SebastianHampl18/Bachelorarbeit/Option1/Datenblätter/Links.txt

NPN:
https://www.reichelt.de/de/de/shop/produkt/bipolartransistor_npn_25v_1a_0_25w_sot-23-45228?PROVID=2788

Microcontroller:
Hardware Design Guidelines: 	https://docs.espressif.com/projects/esp-hardware-design-guidelines/en/latest/esp32/index.html
Schematic Checklist: 		https://docs.espressif.com/projects/esp-hardware-design-guidelines/en/latest/esp32/schematic-checklist.html
PCB Layout Design: 		https://docs.espressif.com/projects/esp-hardware-design-guidelines/en/latest/esp32/pcb-layout-design.html

RFID: https://www.berrybase.de/rfid-lesegeraet-mit-spi-schnittstelle-inkl.-karte-dongle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
