SebastianHampl18/Bachelorarbeit/Dokumentation/Arbeit/Deckblatt.docx

Technische Hochschule Nürnberg Georg Simon Ohm
Fakultät Elektro-, Feinwerk-, Informationstechnik

Studiengang Bachelor Elektro- und Informationstechnik
Vertiefungsrichtung Automatisierungstechnik

Bachelorarbeit von
Sebastian Hampl

Entwicklung modularer Steuer- und Kommunikationsschnittstellen für
Elektrokarts auf einem zentralen Steuergerät

Sommersemester 2025
Abgabedatum: 01. Oktober 2025

Betreuer: Firmenbetreuer:
Prof. Dr. Hritam Dutta M. Eng. K. Beckert
leomax engineering GmbH
