SebastianHampl18/Bachelorarbeit/Dokumentation/Arbeit/Prüfungsrechtliche Erklärung unterschrieben.pdf

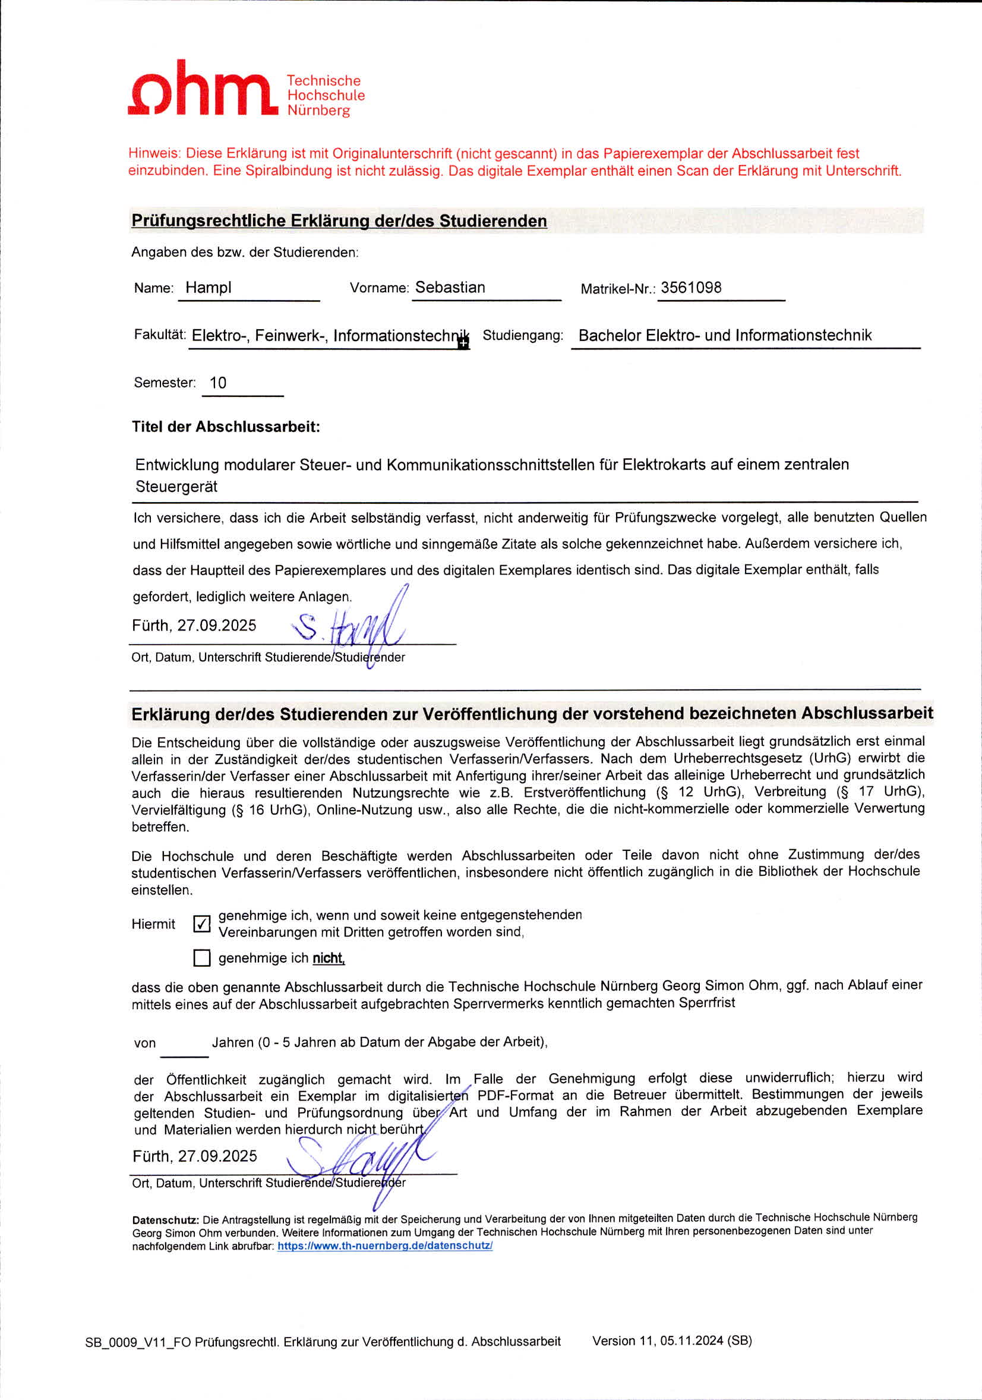
[picture p118: page 1]
