SebastianHampl18/Bachelorarbeit/Option1/Bilder/Strapping Config.png

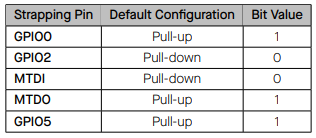
Option1/Bilder/Strapping Config.png
