SebastianHampl18/Bachelorarbeit/Dokumentation/Paarvergleich_Nutzwertanalysen.xlsx

Sheet: Tabelle1
 |  |  | 0 |  |  |  | Nutzwertanalyse
 | Paarvergleich
 |  |  |  |  |  |  | Kriterien | Normiert | Konzept
 | Kriterien | 0 |  | Summe | Normiert | Beschreibung des Kriteriums (Ausprägung, Bewertungsgrenzen, …) |  |  | Bewertung | Gewichtet | Bewertung | Gewichtet | Bewertung | Gewichtet | Bewertung | Gewichtet | Bewertung | Gewichtet
 |  |  |  | 0 | #DIV/0! |  |  | #DIV/0! |  | #DIV/0! |  | #DIV/0! |  | #DIV/0! |  | #DIV/0! |  | #DIV/0!
 |  |  |  | 0 | #DIV/0! |  |  | #DIV/0! |  | #DIV/0! |  | #DIV/0! |  | #DIV/0! |  | #DIV/0! |  | #DIV/0!
2 |  |  |  | 0 | #DIV/0! |  |  | #DIV/0! |  | #DIV/0! |  | #DIV/0! |  | #DIV/0! |  | #DIV/0! |  | #DIV/0!
 |  |  |  | 0 | #DIV/0! |  |  | #DIV/0! |  | #DIV/0! |  | #DIV/0! |  | #DIV/0! |  | #DIV/0! |  | #DIV/0!
 |  |  |  | 0 | #DIV/0! |  |  | #DIV/0! |  | #DIV/0! |  | #DIV/0! |  | #DIV/0! |  | #DIV/0! |  | #DIV/0!
 |  |  |  | 0 | #DIV/0! |  |  | #DIV/0! |  | #DIV/0! |  | #DIV/0! |  | #DIV/0! |  | #DIV/0! |  | #DIV/0!
 |  |  |  | 0 | #DIV/0! |  |  | #DIV/0! |  | #DIV/0! |  | #DIV/0! |  | #DIV/0! |  | #DIV/0! |  | #DIV/0!
 |  |  |  | 0 | #DIV/0! |  |  | #DIV/0! |  | #DIV/0! |  | #DIV/0! |  | #DIV/0! |  | #DIV/0! |  | #DIV/0!
 |  |  |  | 0 | #DIV/0! |  |  | #DIV/0! |  | #DIV/0! |  | #DIV/0! |  | #DIV/0! |  | #DIV/0! |  | #DIV/0!
 |  |  |  | 0 | #DIV/0! |  |  | #DIV/0! |  | #DIV/0! |  | #DIV/0! |  | #DIV/0! |  | #DIV/0! |  | #DIV/0!
 |  |  |  | 0 | #DIV/0! |  |  |  | #DIV/0! |  | #DIV/0! |  | #DIV/0! |  | #DIV/0! |  | #DIV/0!
 |  |  |  |  |  |  |  |  | #DIV/0! |  | #DIV/0! |  | #DIV/0! |  | #DIV/0! |  | #DIV/0!
 | "2" - Zeile wichtiger als Spalte "1" - Beide Kriterien gleich wichtig "0" - Spalte wichtiger als Zeile |  |  |  |  |  | "3" - Sehr gute Erfüllung des Kriteriums "2" - Gute Erfüllung des Kriteriums "1" - Befriedigende Erfüllung des Kriteriums "0" - Mangelhafte Erfüllung des Kriteriums

Sheet: Tabelle2
 | Paarvergleich | 0 |  |  |  | Nutzwertanalyse |  | Konzept 1 |  | Konzept 1 |  | Konzept 1 |  | Konzept 1
 | Kriterien |  | Summe | Normiert | Beschreibung des Kriteriums | Kriterien | Normiert | Bewertung | Gewichtet | Bewertung | Gewichtet | Bewertung | Gewichtet | Bewertung | Gewichtet
2 |  |  | 0 | #DIV/0! |  |  | #DIV/0! |  | #DIV/0! |  | #DIV/0! |  | #DIV/0! |  | #DIV/0!
 |  |  | 0 | #DIV/0! |  |  | #DIV/0! |  | #DIV/0! |  | #DIV/0! |  | #DIV/0! |  | #DIV/0!
 |  |  | 0 | #DIV/0! |  |  | #DIV/0! |  | #DIV/0! |  | #DIV/0! |  | #DIV/0! |  | #DIV/0!
 |  |  | 0 | #DIV/0! |  |  | #DIV/0! |  | #DIV/0! |  | #DIV/0! |  | #DIV/0! |  | #DIV/0!
 |  |  | 0 | #DIV/0! |  |  | #DIV/0! |  | #DIV/0! |  | #DIV/0! |  | #DIV/0! |  | #DIV/0!
 |  |  | 0 | #DIV/0! |  |  | #DIV/0! |  | #DIV/0! |  | #DIV/0! |  | #DIV/0! |  | #DIV/0!
 |  |  | 0 | #DIV/0! |  |  | #DIV/0! |  | #DIV/0! |  | #DIV/0! |  | #DIV/0! |  | #DIV/0!
 |  |  | 0 | #DIV/0! |  |  | #DIV/0! |  | #DIV/0! |  | #DIV/0! |  | #DIV/0! |  | #DIV/0!
 |  |  | 0 | #DIV/0! |  |  | #DIV/0! |  | #DIV/0! |  | #DIV/0! |  | #DIV/0! |  | #DIV/0!
 |  |  | 0 | #DIV/0! |  |  | #DIV/0! |  | #DIV/0! |  | #DIV/0! |  | #DIV/0! |  | #DIV/0!
 |  |  | 0 | #DIV/0! |  |  |  | #DIV/0! |  | #DIV/0! |  | #DIV/0! |  | #DIV/0!
 |  |  |  |  |  |  |  | #DIV/0! |  | #DIV/0! |  | #DIV/0! |  | #DIV/0!

Sheet: Beispiel
 | Paarvergleich | 0 |  |  |  |  |  |  |  | Nutzwertanalyse |  | Konzept 1 |  | Konzept 2 |  | Konzept 3 |  | Konzept 4
 | Kriterien | Kosten | Aufwand | Störungssicherheit | Wartbarkeit | Fehlersuche | Summe | Normiert | Beschreibung des Kriteriums | Kriterien | Normiert | Bewertung | Gewichtet | Bewertung | Gewichtet | Bewertung | Gewichtet | Bewertung | Gewichtet
2 | Kosten |  | 2 | 0 | 0 | 0 | 2 | 0.1 | Möglichst geringe gesamtkosten für Anschaffung und Entwicklung des Systems | Kosten | 0.1 | 3 | 0.3 | 2 | 0.2 | 0 | 0 | 2 | 0.2
 | Aufwand | 0 |  | 0 | 0 | 0 | 0 | 0 | möglichst niedriger zeitlicher Aufwand von der Entwicklung bis zum fertigen Produkt | Aufwand | 0 | 3 | 0 | 1 | 0 | 0 | 0 | 2 | 0
 | Störungssicherheit | 2 | 2 |  | 2 | 2 | 8 | 0.4 | bestmögliche Resistenz gegenüber elektrischen Störungen wie EMV | Störungssicherheit | 0.4 | 0 | 0 | 3 | 1.2 | 3 | 1.2 | 1 | 0.4
 | Wartbarkeit | 2 | 2 | 0 |  | 1 | 5 | 0.25 | beste Möglichkeiten zur Fehlerbehebung und Fehlervermeidung | Wartbarkeit | 0.25 | 0 | 0 | 1 | 0.25 | 2 | 0.5 | 3 | 0.75
 | Fehlersuche | 2 | 2 | 0 | 1 |  | 5 | 0.25 | möglichst geringer Aufwand um aufgetretene fehler zu Identifizieren | Fehlersuche | 0.25 | 0 | 0 | 1 | 0.25 | 2 | 0.5 | 3 | 0.75
 |  |  |  |  |  |  | 0 | 0 |  |  | 0 |  | 0 |  | 0 |  | 0 |  | 0
 |  |  |  |  |  |  | 0 | 0 |  |  | 0 |  | 0 |  | 0 |  | 0 |  | 0
 |  |  |  |  |  |  | 0 | 0 |  |  | 0 |  | 0 |  | 0 |  | 0 |  | 0
 |  |  |  |  |  |  | 0 | 0 |  |  | 0 |  | 0 |  | 0 |  | 0 |  | 0
 |  |  |  |  |  |  | 0 | 0 |  |  | 0 |  | 0 |  | 0 |  | 0 |  | 0
 |  |  |  |  |  |  | 20 | 1 |  |  |  | 0.3 |  | 1.9 |  | 2.2 |  | 2.1
 |  |  |  |  |  |  |  |  |  |  |  | 4 |  | 3 |  | 1 |  | 2

Sheet: Wireless Datatransfer
 | Paarvergleich | 0 |  |  |  |  |  |  |  |  |  |  |  |  | Nutzwertanalyse |  | Bluetooth |  | Wlan |  | LoRa |  | LTE
 | Kriterien | Übertragungsrate | Kosten | Entwicklungsaufwand | Reichweite | Nutzerfreundlichkeit | Energieverbrauch | Störsicherheit | Bauraum | Kompatibilität | Sicherheit | Summe | Normiert | Beschreibung des Kriteriums | Kriterien | Normiert | Bewertung | Gewichtet | Bewertung | Gewichtet | Bewertung | Gewichtet | Bewertung | Gewichtet
2 | Übertragungsrate |  | 2 | 2 | 2 | 0 | 2 | 1 | 2 | 0 | 0 | 11 | 0.1222222222 | Die Geschwindigkeit mit welcher große Datenmengen übertragen werden können | Übertragungsrate | 0.1222222222 | 2 | 0.2444444444 | 3 | 0.3666666667 | 0 | 0 | 3 | 0.3666666667
 | Kosten | 0 |  | 2 | 2 | 0 | 2 | 0 | 2 | 0 | 0 | 8 | 0.08888888889 | Kosten für Entwicklung, Aufbau und Service des Systems | Kosten | 0.08888888889 | 3 | 0.3666666667 | 3 | 0.3666666667 | 2 | 0.2444444444 | 0 | 0
 | Entwicklungsaufwand | 0 | 0 |  | 0 | 0 | 0 | 0 | 2 | 0 | 0 | 2 | 0.02222222222 | Aufwand zur Entwicklung und Instandhaltung des Systems | Entwicklungsaufwand | 0.02222222222 | 1 | 0.1222222222 | 2 | 0.2444444444 | 1 | 0.1222222222 | 0 | 0
 | Reichweite | 0 | 0 | 2 |  | 0 | 2 | 0 | 2 | 0 | 0 | 6 | 0.06666666667 | Reichweite in welcher die Daten sicher und schnell übertragbar sind | Reichweite | 0.06666666667 | 1 | 0.1222222222 | 2 | 0.2444444444 | 3 | 0.3666666667 | 3 | 0.3666666667
 | Nutzerfreundlichkeit | 2 | 2 | 2 | 2 |  | 2 | 2 | 2 | 1 | 0 | 15 | 0.1666666667 | Einfache Handhabung wie Verbindung und Download | Nutzerfreundlichkeit | 0.1666666667 | 1 | 0.1222222222 | 3 | 0.3666666667 | 0 | 0 | 3 | 0.3666666667
 | Energieverbrauch | 0 | 0 | 2 | 0 | 0 |  | 0 | 2 | 0 | 0 | 4 | 0.04444444444 | Leistungsaufnahme des Systems im Idle State | Energieverbrauch | 0.04444444444 | 3 | 0.3666666667 | 1 | 0.1222222222 | 2 | 0.2444444444 | 0 | 0
 | Störsicherheit | 1 | 2 | 2 | 2 | 0 | 2 |  | 2 | 0 | 0 | 11 | 0.1222222222 | Anfälligkeit des Systems gegenüber Störungen wie EMV, die die Datenübertragung erschweren | Störsicherheit | 0.1222222222 | 1 | 0.1222222222 | 2 | 0.2444444444 | 3 | 0.3666666667 | 3 | 0.3666666667
 | Bauraum | 0 | 0 | 0 | 0 | 0 | 0 | 0 |  | 0 | 0 | 0 | 0 | Große des Moduls auf der Platine | Bauraum | 0 | 3 | 0.3666666667 | 3 | 0.3666666667 | 2 | 0.2444444444 | 1 | 0.1222222222
 | Kompatibilität | 2 | 2 | 2 | 2 | 1 | 2 | 2 | 2 |  | 0 | 15 | 0.1666666667 | Kompatibilität des Systems mit weit verbreiteten Betriebssystemen für Mobile geräte | Kompatibilität | 0.1666666667 | 3 | 0.3666666667 | 3 | 0.3666666667 | 0 | 0 | 1 | 0.1222222222
 | Sicherheit | 2 | 2 | 2 | 2 | 2 | 2 | 2 | 2 | 2 |  | 18 | 0.2 | Schutz vor unbefugtem Zugriff | Sicherheit | 0.2 | 1 | 0.1222222222 | 2 | 0.2444444444 | 0 | 0 | 3 | 0.3666666667
 |  |  |  |  |  |  |  |  |  |  |  | 90 | 1 |  |  |  | 2.322222222 |  | 2.933333333 |  | 1.588888889 |  | 2.077777778
 |  |  |  |  |  |  |  |  |  |  |  |  |  |  |  |  | 2 |  | 1 |  | 4 |  | 3

Sheet: Display
 | Paarvergleich | 0 |  |  |  |  |  |  |  |  |  | Nutzwertanalyse |  | Monocromes LCD Display |  | OLED Display |  | TFT-LCD Display
 | Kriterien | Kosten | Entwicklungsaufwand | Bauraum | Energieverbrauch | Darstellung | Bedienbarkeit | Größe | Summe | Normiert | Beschreibung des Kriteriums | Kriterien | Normiert | Bewertung | Gewichtet | Bewertung | Gewichtet | Bewertung | Gewichtet
2 | Kosten |  | 2 | 2 | 2 | 0 | 0 | 0 | 6 | 0.1428571429 | Kosten des gesamtmoduls | Kosten | 0.1428571429 | 3 | 0.4285714286 | 2 | 0.2857142857 | 1 | 0.1428571429
 | Entwicklungsaufwand | 0 |  | 0 | 0 | 0 | 0 | 0 | 0 | 0 | Entwicklungsaufwand für Anzeige und Kommunikation | Entwicklungsaufwand | 0 | 3 | 0 | 2 | 0 | 1 | 0
 | Bauraum | 0 | 2 |  | 2 | 0 | 0 | 0 | 4 | 0.09523809524 | gesamter bauraum für Display und Eingabemöglichkeiten | Bauraum | 0.09523809524 | 3 | 0.2857142857 | 3 | 0.2857142857 | 2 | 0.1904761905
 | Energieverbrauch | 0 | 2 | 0 |  | 0 | 0 | 0 | 2 | 0.04761904762 | Stromverbrauch des Displays | Energieverbrauch | 0.04761904762 | 3 | 0.1428571429 | 2 | 0.09523809524 | 1 | 0.04761904762
 | Darstellung | 2 | 2 | 2 | 2 |  | 1 | 2 | 11 | 0.2619047619 | Möglichkeit zur farbigen und graphischen Darstellung von Daten | Darstellung | 0.2619047619 | 0 | 0 | 2 | 0.5238095238 | 3 | 0.7857142857
 | Bedienbarkeit | 2 | 2 | 2 | 2 | 1 |  | 2 | 11 | 0.2619047619 | Einfache Eingabemöglichkeiten für den Nutzer | Bedienbarkeit | 0.2619047619 | 0 | 0 | 2 | 0.5238095238 | 3 | 0.7857142857
 | Größe | 2 | 2 | 2 | 2 | 0 | 0 |  | 8 | 0.1904761905 | Tatsächliche Größe des Displays | Größe | 0.1904761905 | 3 | 0.5714285714 | 1 | 0.1904761905 | 3 | 0.5714285714
 |  |  |  |  |  |  |  |  | 42 | 1 |  |  |  | 1.428571429 |  | 1.904761905 |  | 2.523809524
 |  |  |  |  |  |  |  |  |  |  |  |  |  | 3 |  | 2 |  | 1

Sheet: RFID-Reader
 | Paarvergleich | 0 |  |  |  |  |  |  |  |  | Nutzwertanalyse |  | RFID-Reader mit CAN-Interface |  | RFID-Aufsteckmodul
 | Kriterien | Kosten | Entwicklungsaufwand | Kompatibilität | Energieverbrauch | Bauraum | Verschlüsselung | Summe | Normiert | Beschreibung des Kriteriums | Kriterien | Normiert | Bewertung | Gewichtet | Bewertung | Gewichtet | Bewertung | Gewichtet
2 | Kosten |  | 2 | 0 | 2 | 2 | 0 | 6 | 0.2 |  | Kosten | 0.2 | 0 | 0 | 3 | 0.6 |  | 0
 | Entwicklungsaufwand | 0 |  | 0 | 0 | 0 | 0 | 0 | 0 |  | Entwicklungsaufwand | 0 | 3 | 0 | 1 | 0 |  | 0
 | Kompatibilität | 2 | 2 |  | 2 | 2 | 1 | 9 | 0.3 | Erkennt Desfire EV3 Karten | Kompatibilität | 0.3 | 3 | 0.9 | 0 | 0 |  | 0
 | Energieverbrauch | 0 | 2 | 0 |  | 1 | 0 | 3 | 0.1 |  | Energieverbrauch | 0.1 | 1 | 0.1 | 3 | 0.3 |  | 0
 | Bauraum | 0 | 2 | 0 | 1 |  | 0 | 3 | 0.1 |  | Bauraum | 0.1 | 1 | 0.1 | 3 | 0.3 |  | 0
 | Verschlüsselung | 2 | 2 | 1 | 2 | 2 |  | 9 | 0.3 |  | Verschlüsselung | 0.3 | 3 | 0.9 | 0 | 0 |  | 0
 |  |  |  |  |  |  |  | 30 | 1 |  |  |  | 2 |  | 1.2 |  | 0
 |  |  |  |  |  |  |  |  |  |  |  |  | 1 |  | 2 |  | 3
