SebastianHampl18/Bachelorarbeit/Option1/Option1.step

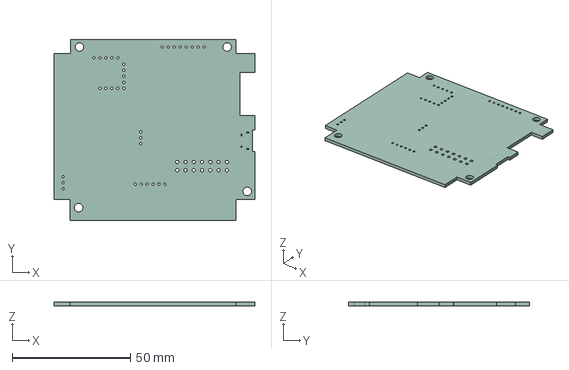
[picture p120: CAD file, 2025-08-19]
Option1/Option1.step
85.0 x 76.5 x 1.51 mm
