SebastianHampl18/Bachelorarbeit/Option1/Datenblätter/Oszillator CAN.pdf

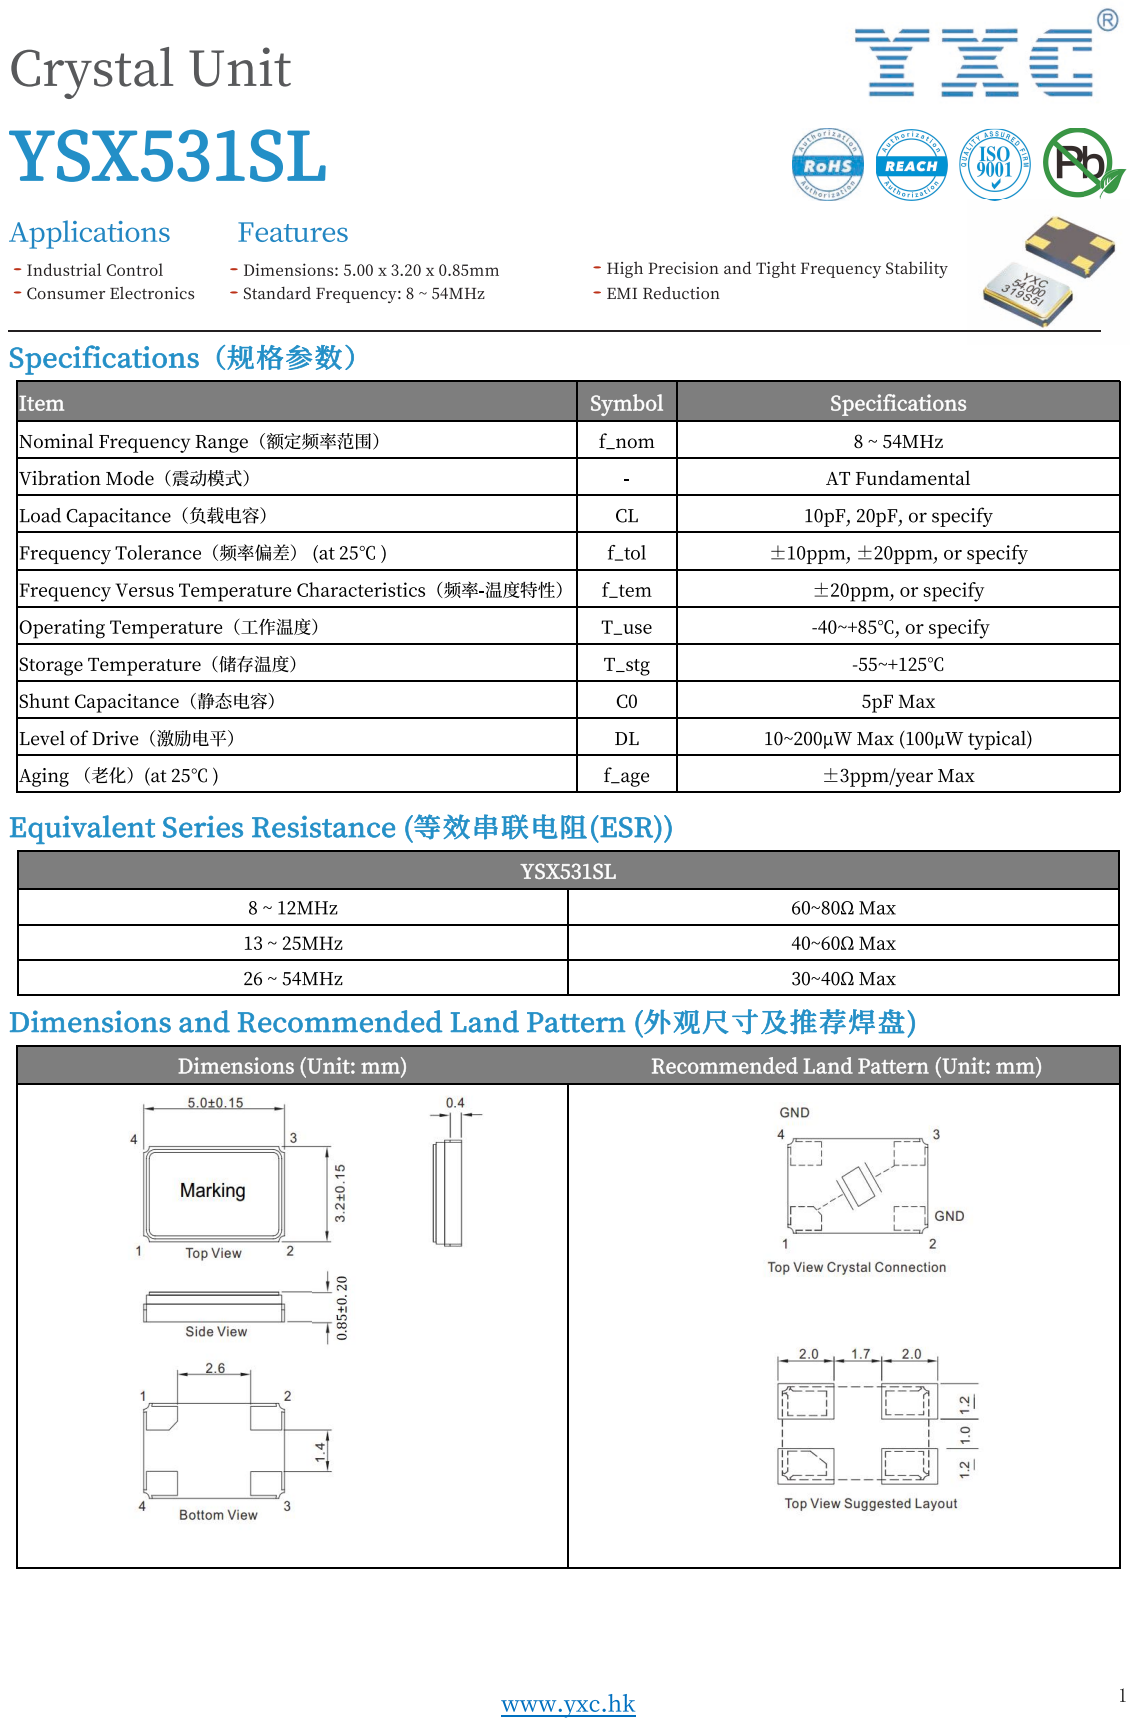
[picture p138: page 1]
