SebastianHampl18/Bachelorarbeit/Option1/Export/Schaltplan review 1.pdf

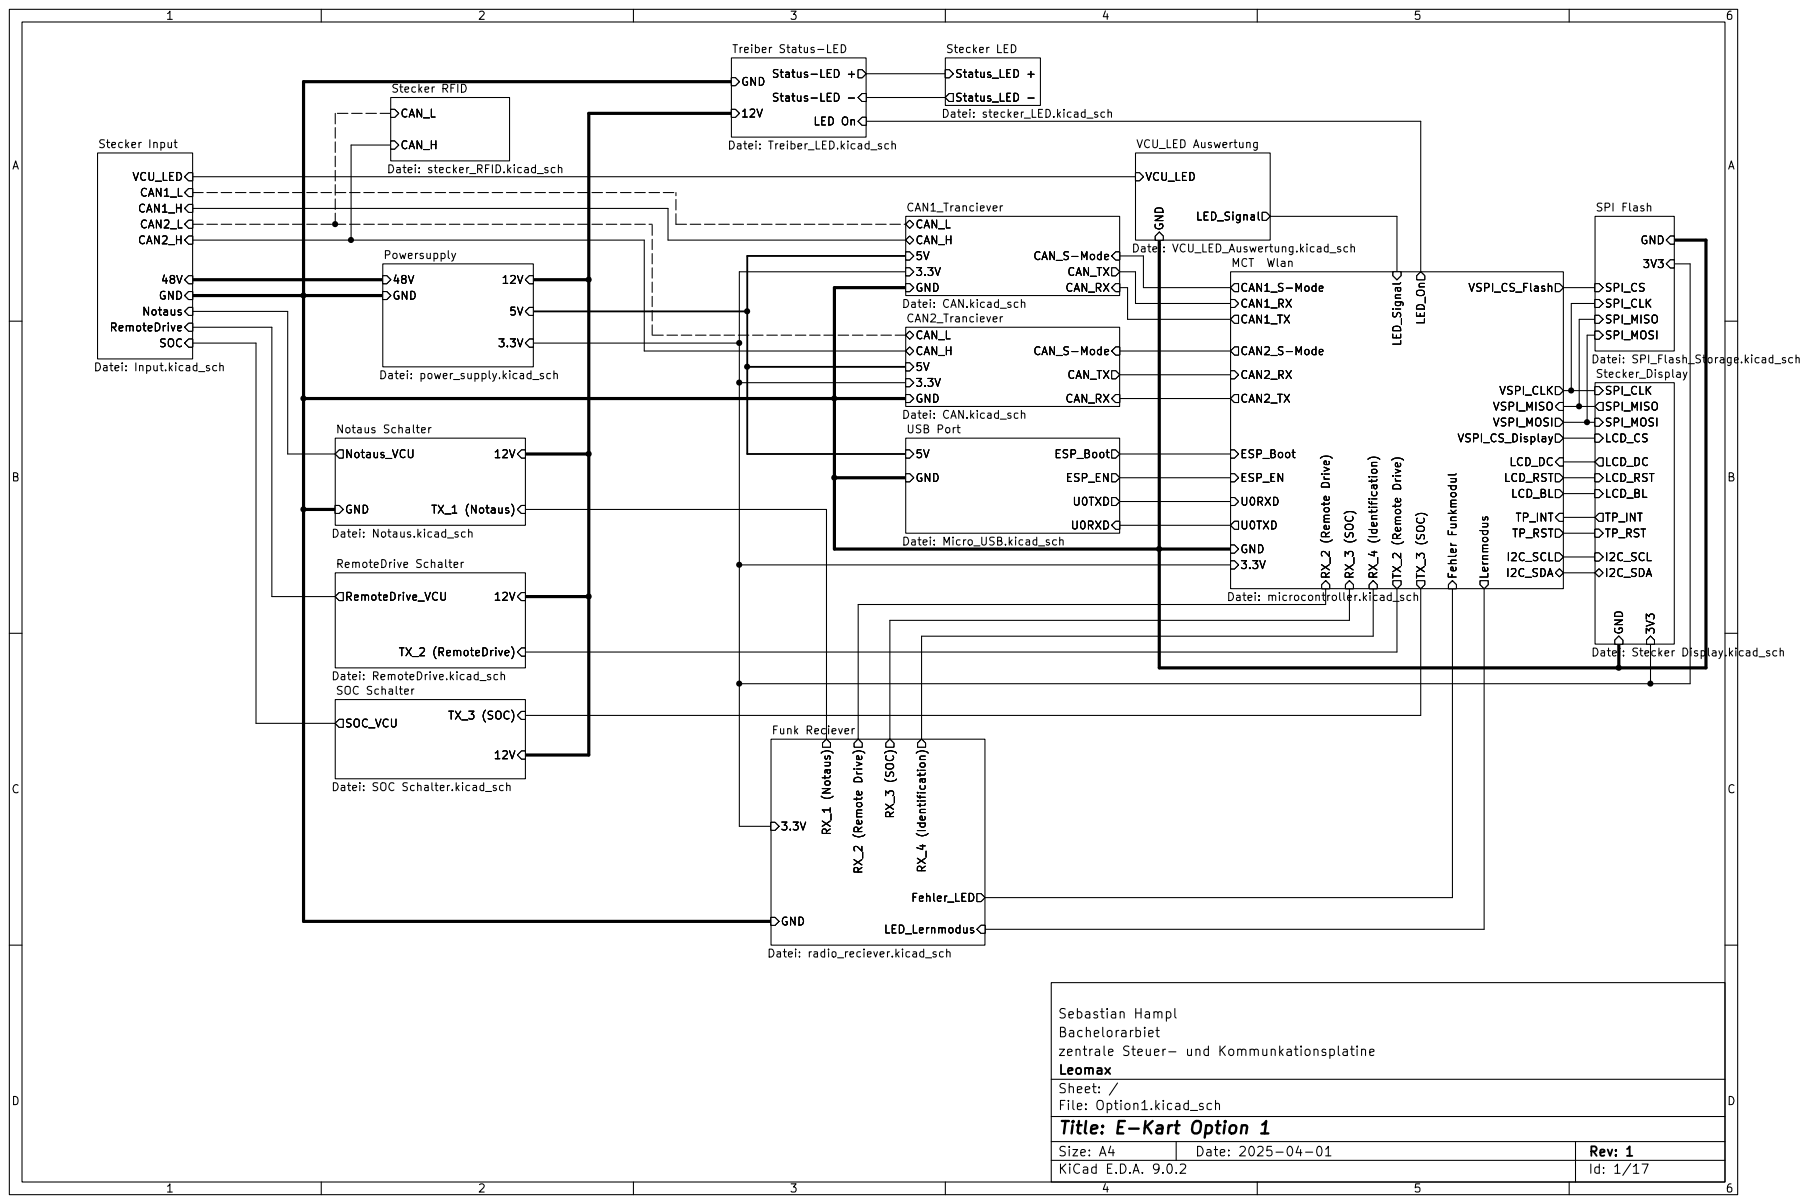
[picture p139: page 1]

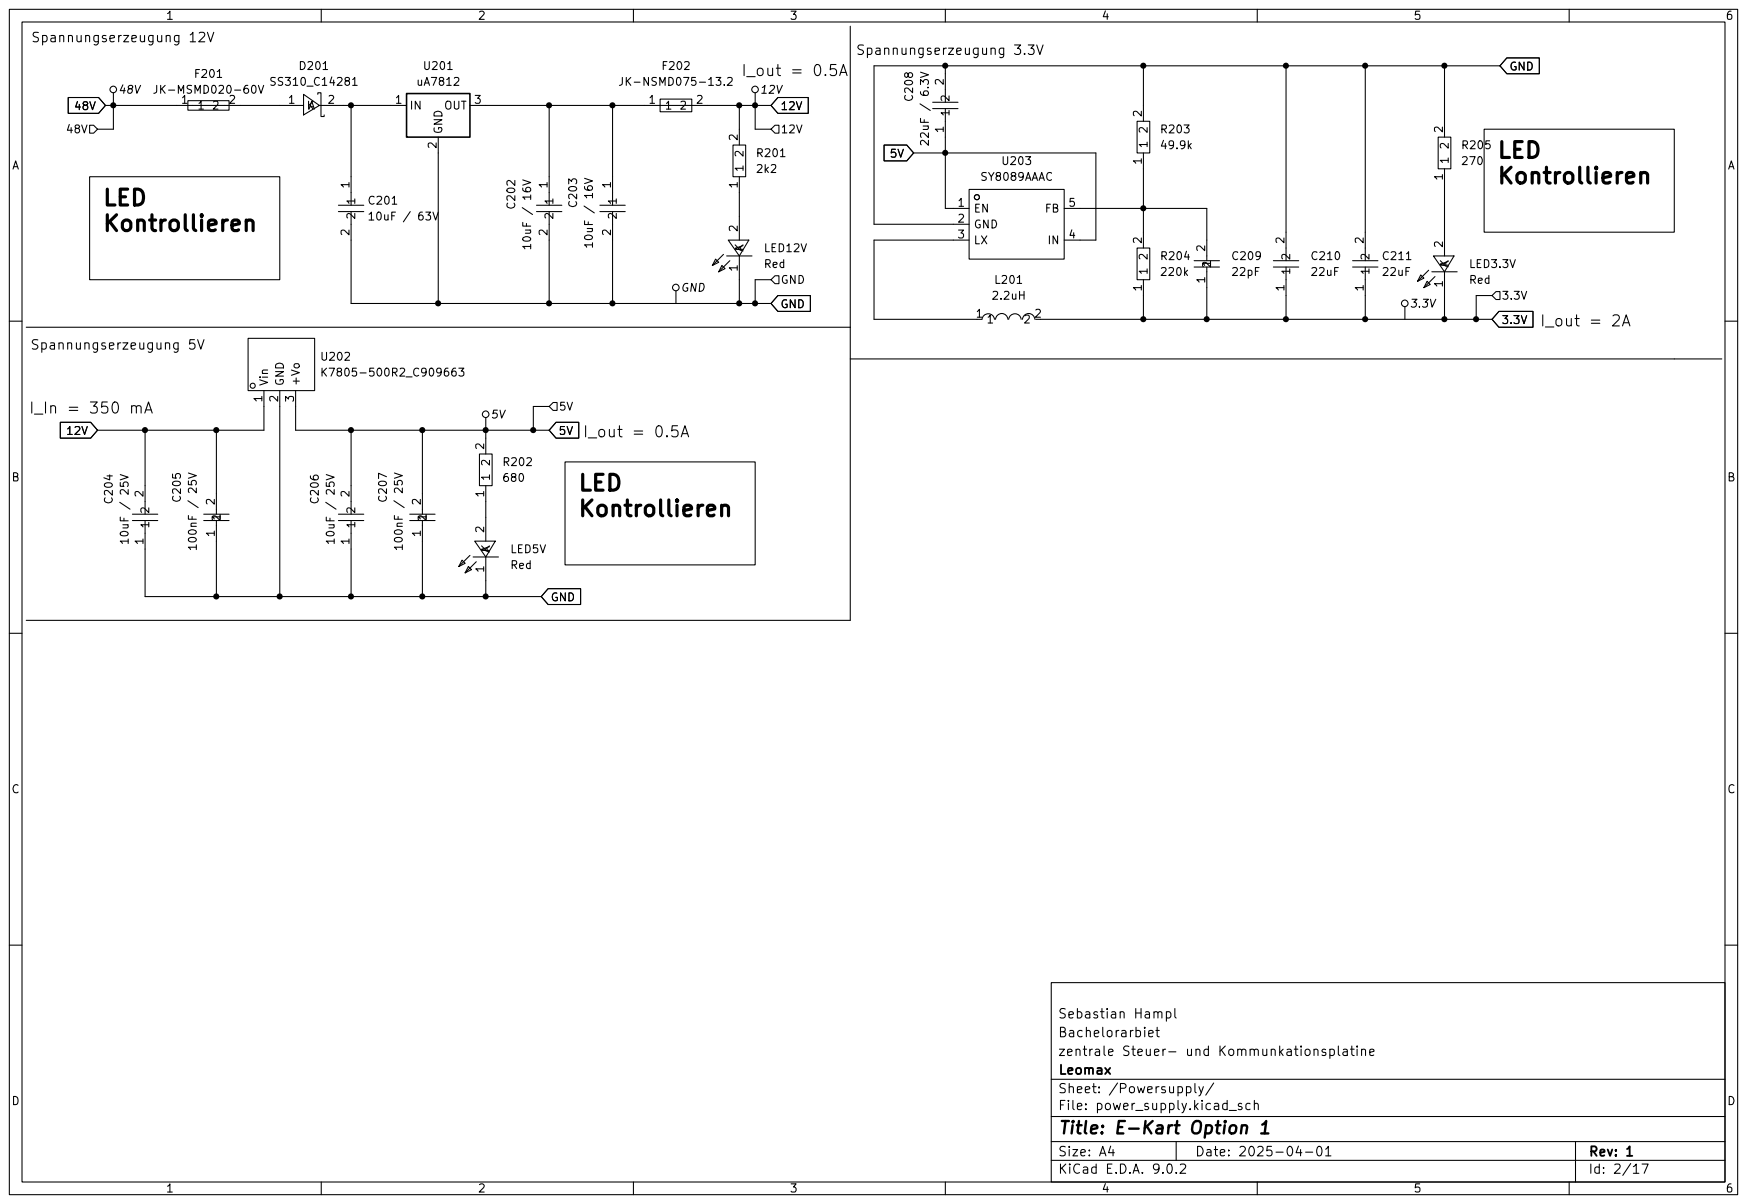
[picture p140: page 2]

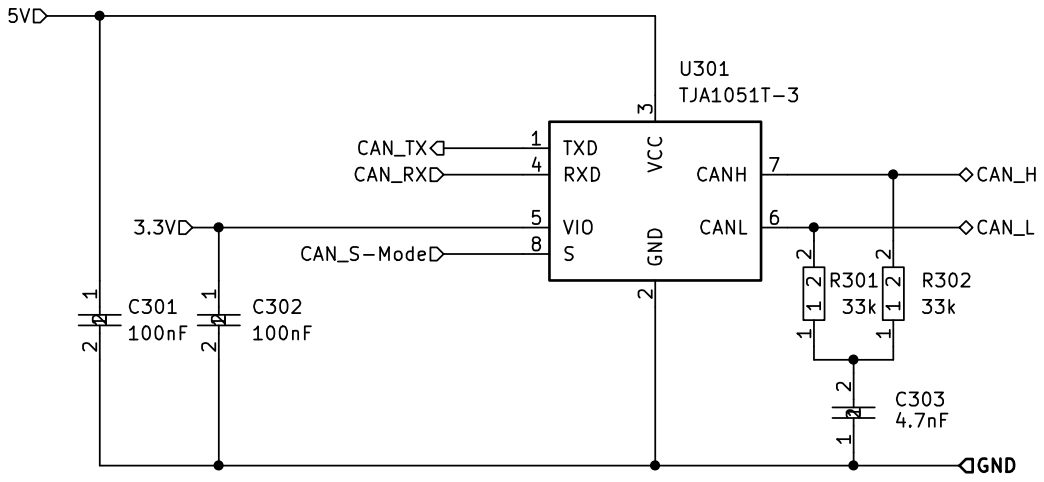
[picture p141: page 3]

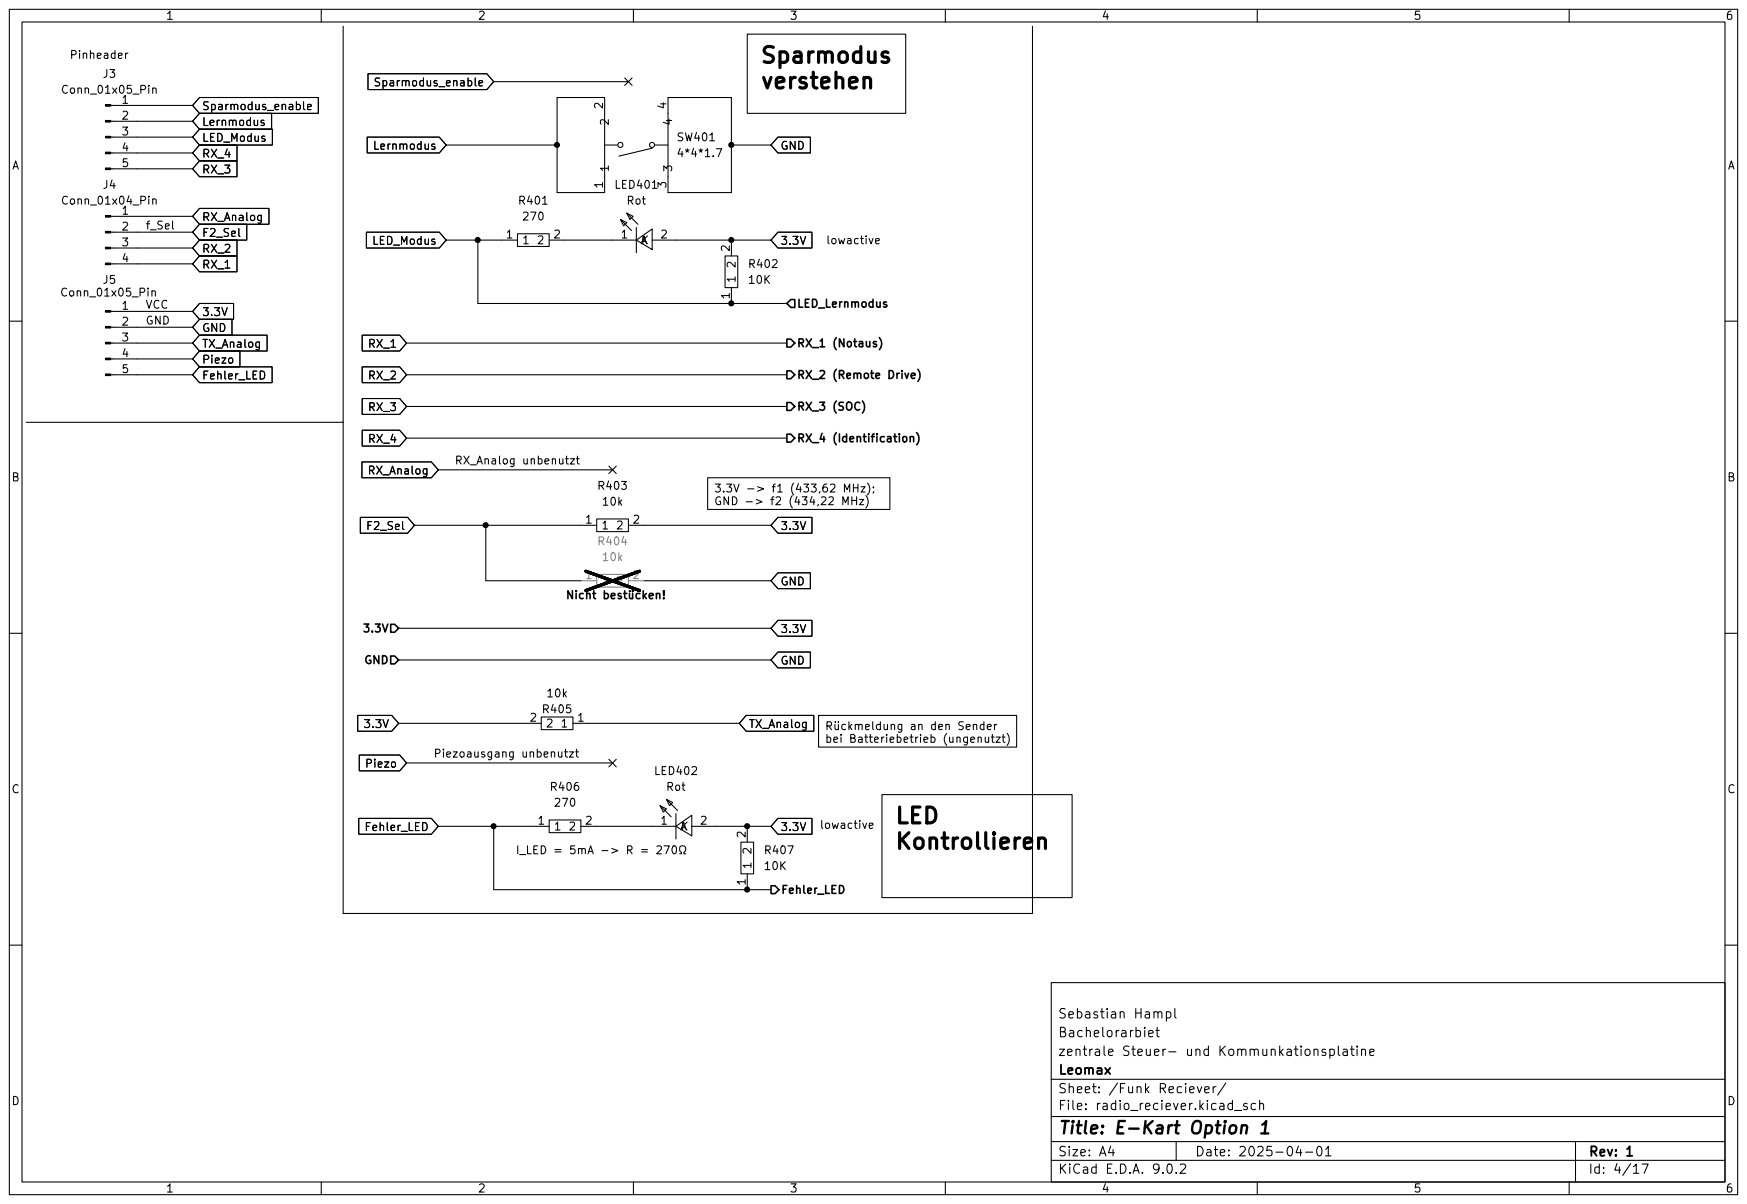
[picture p142: page 4]

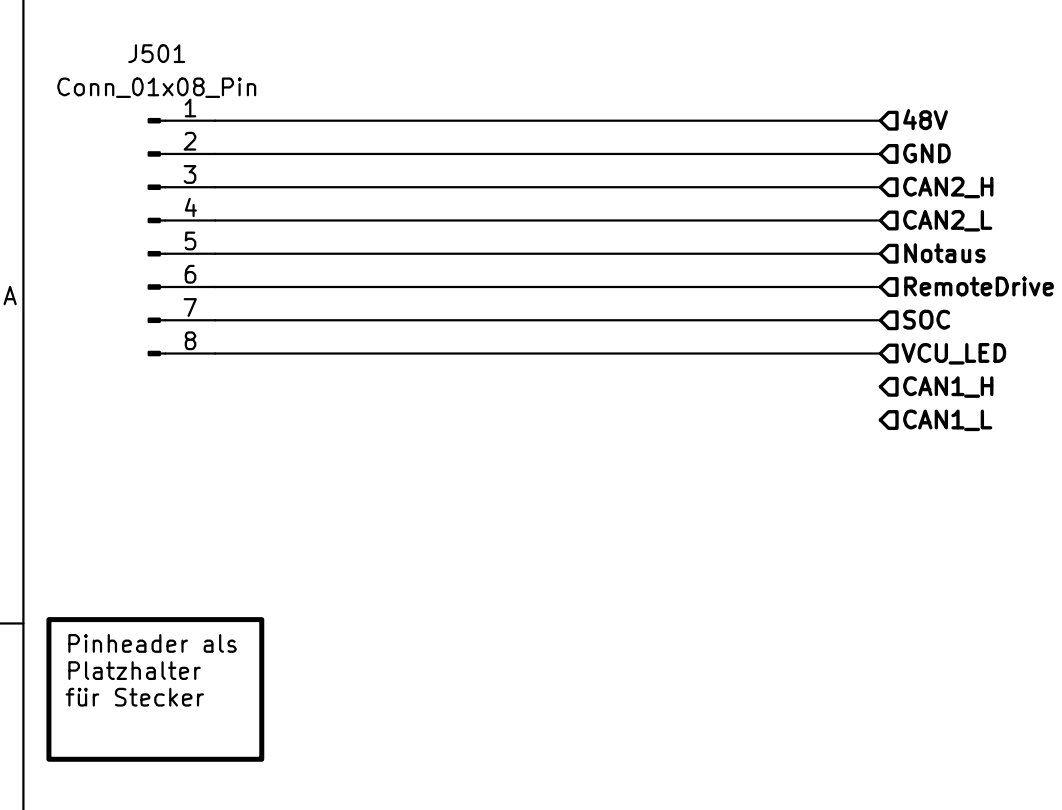
[picture p143: page 5]

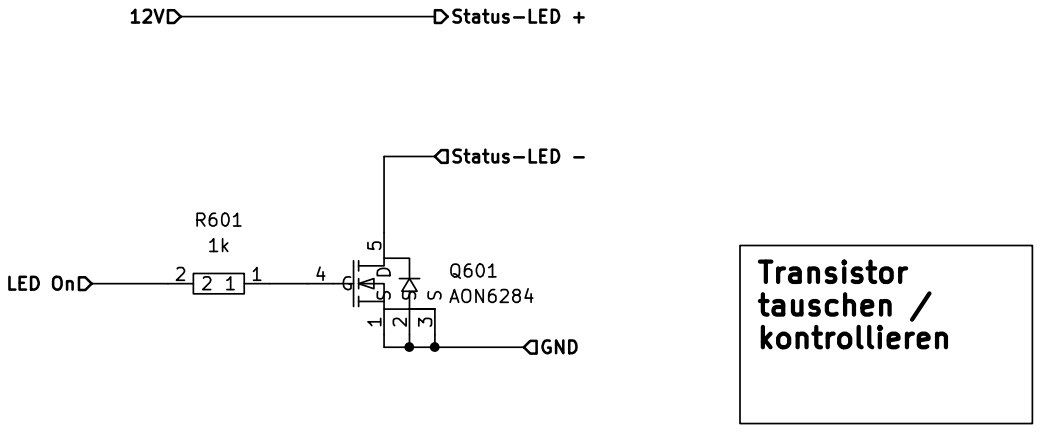
[picture p144: page 6]

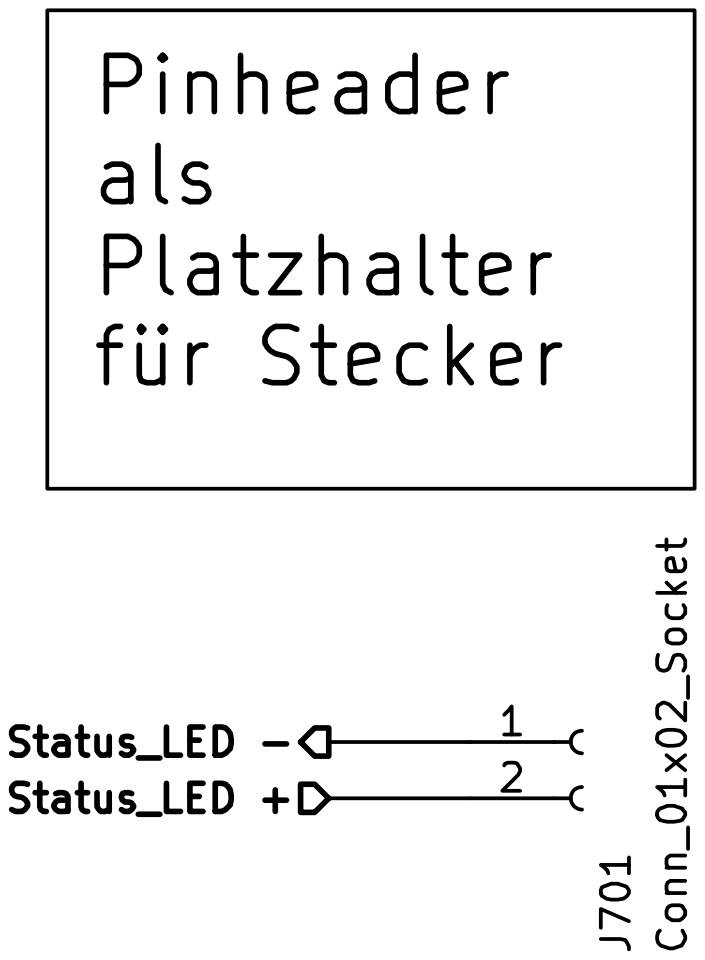
[picture p145: page 7]

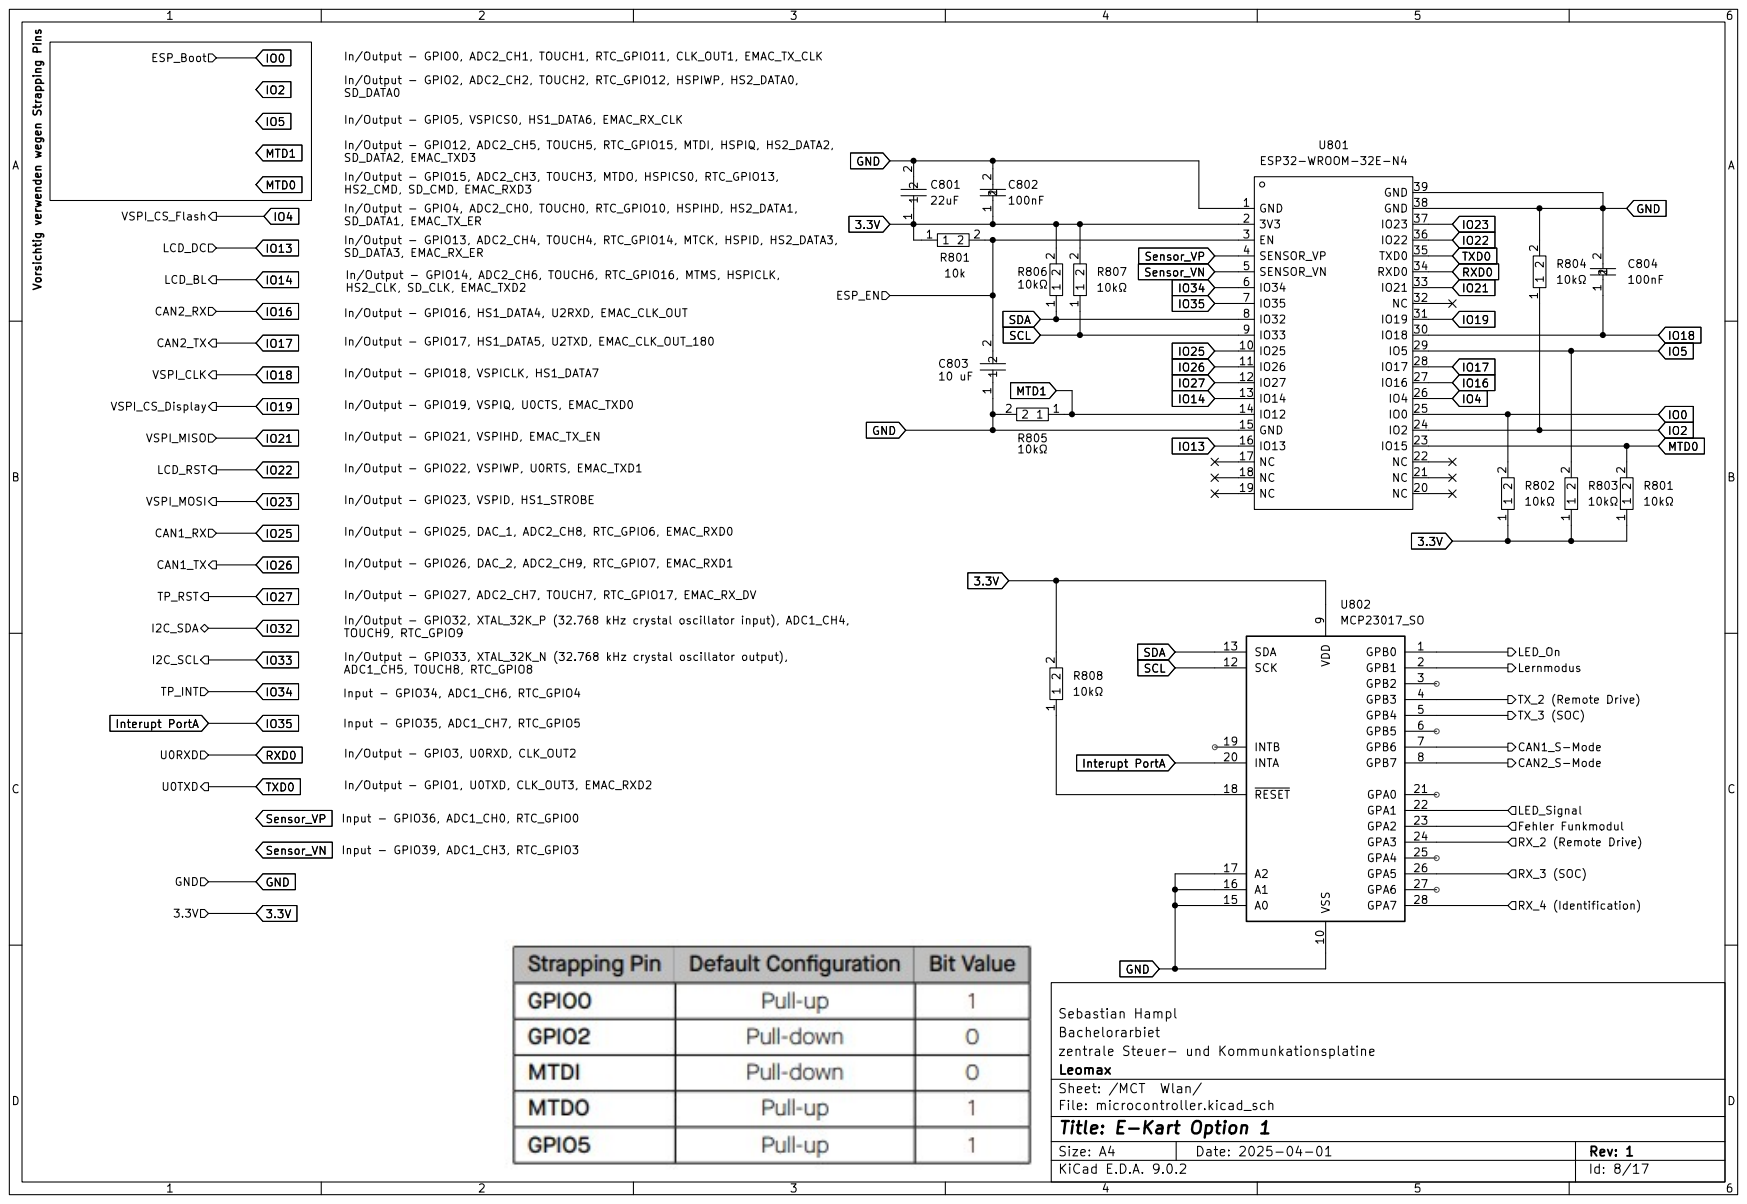
[picture p146: page 8]

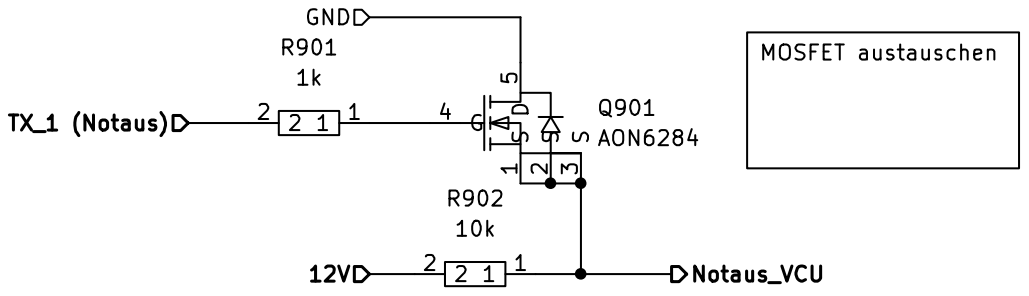
[picture p147: page 9]

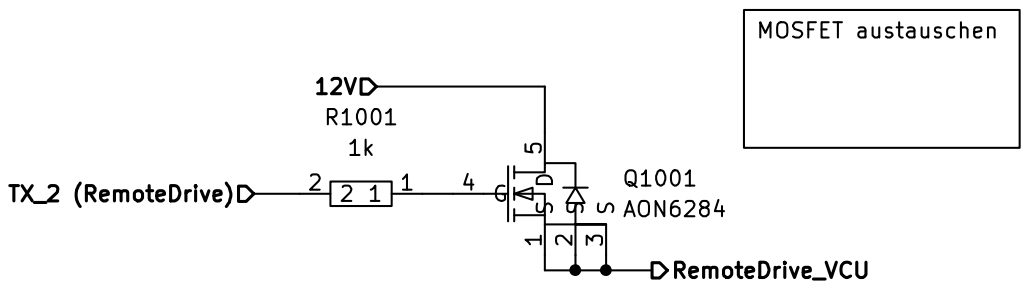
[picture p148: page 10]

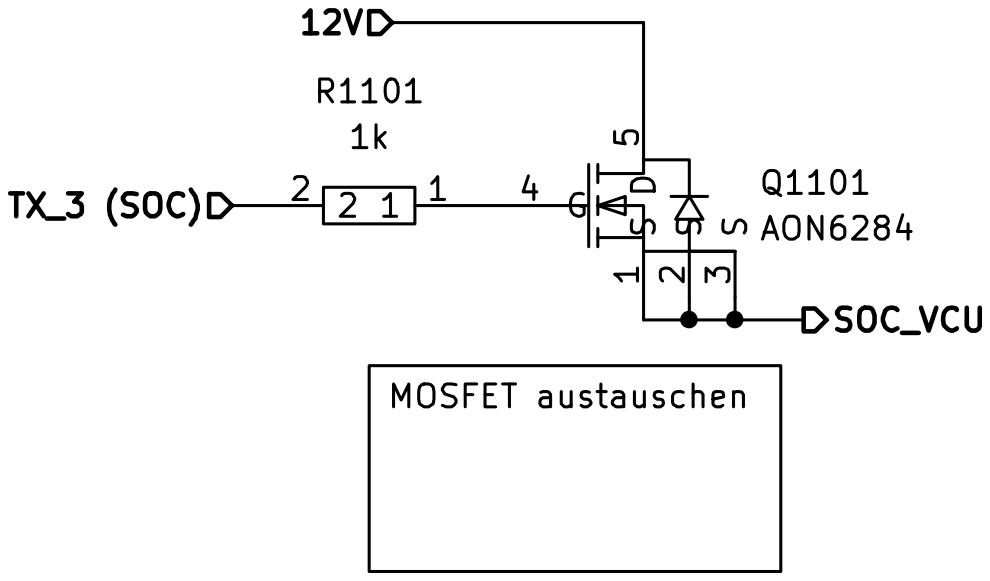
[picture p149: page 11]

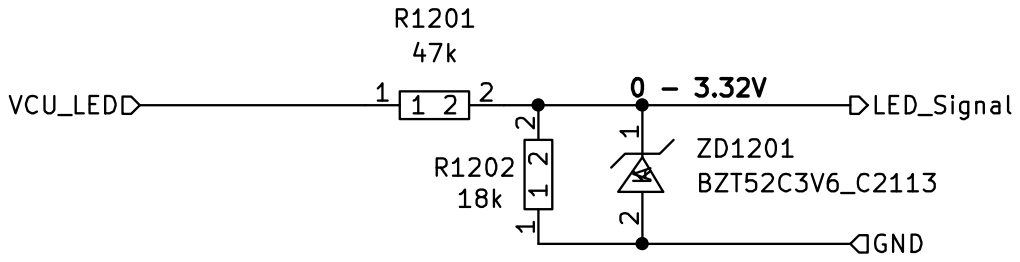
[picture p150: page 12]

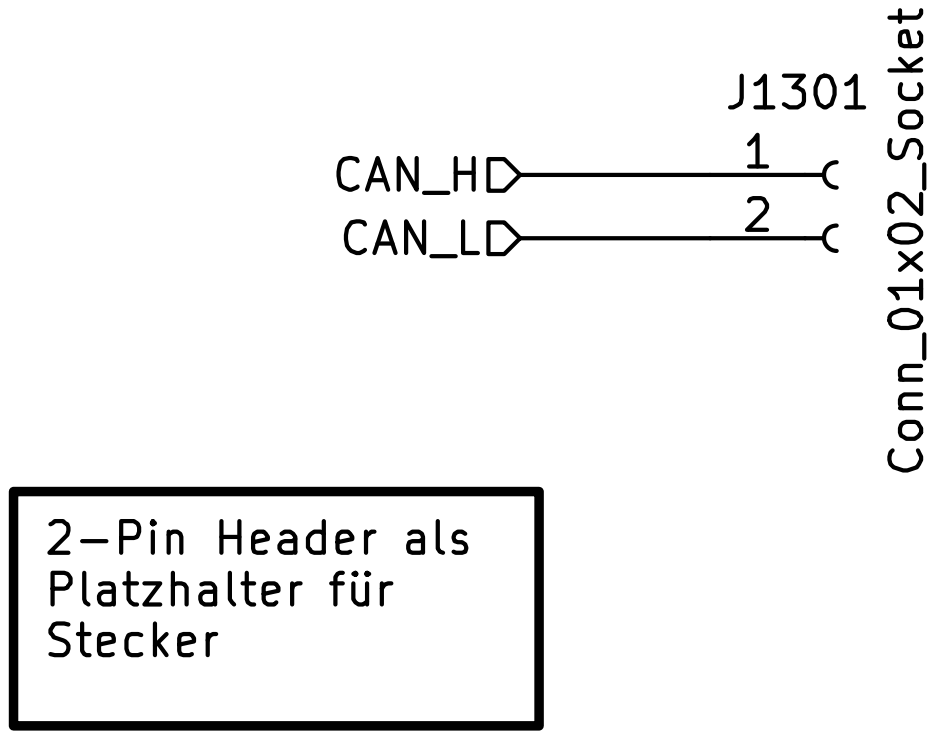
[picture p151: page 13]

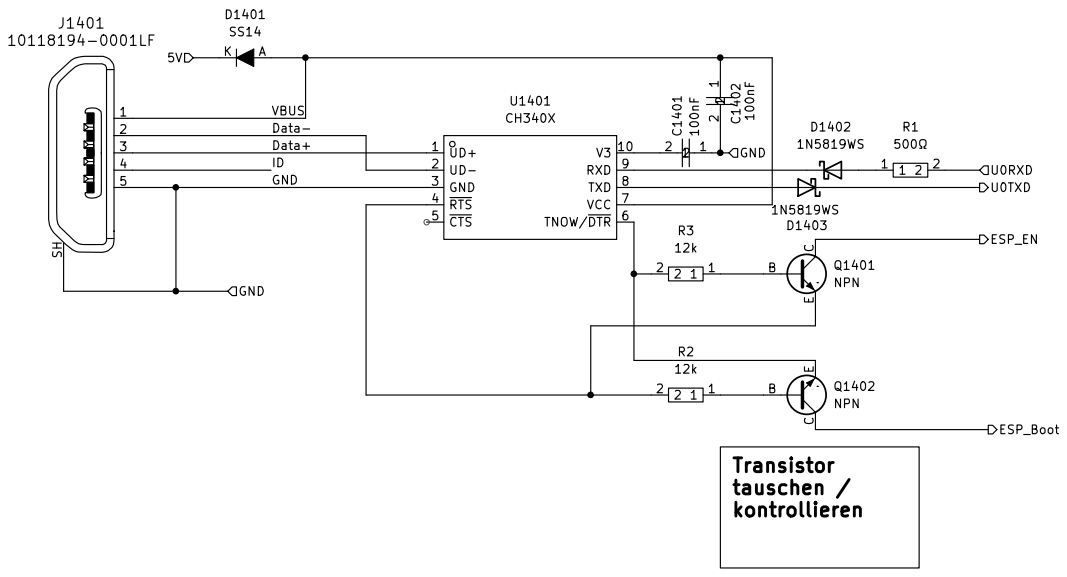
[picture p152: page 14]

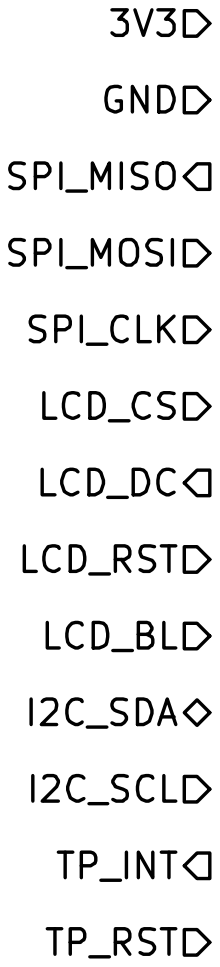
[picture p153: page 15]

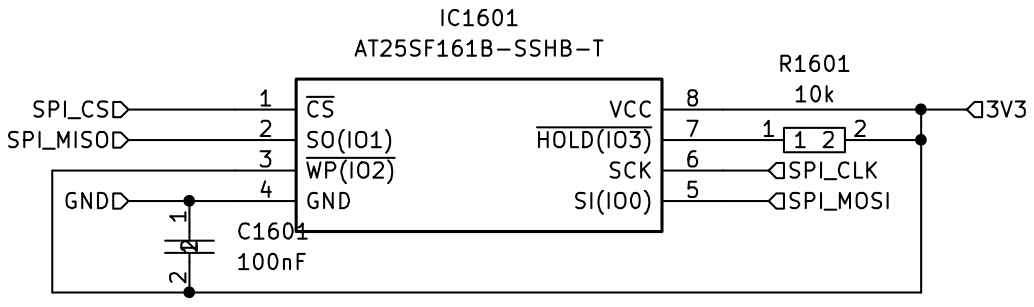
[picture p154: page 16]

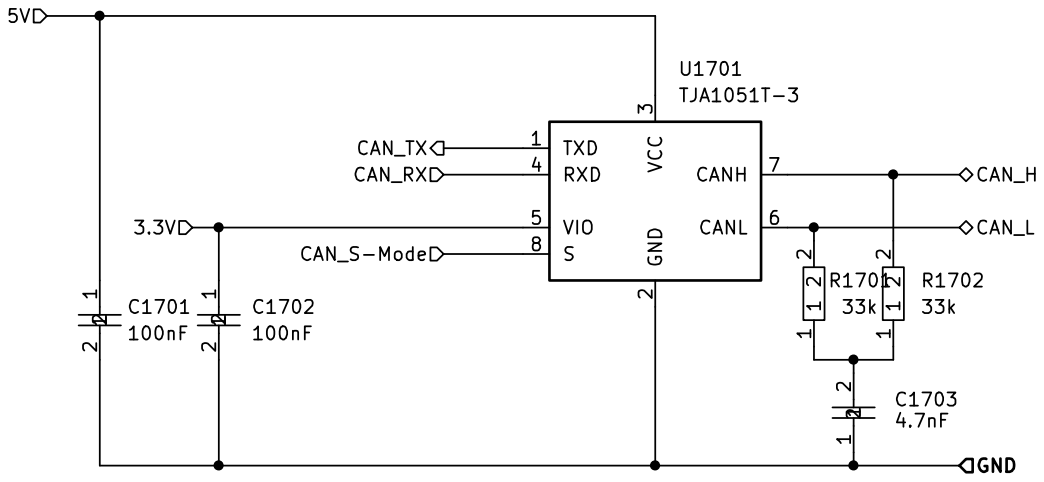
[picture p155: page 17]
