SebastianHampl18/Bachelorarbeit/Option1/LED Schaltungen.asc

R1: res; 47k
R2: res; 18k
V1: voltage; 12
Named nets: messpunkt, 0
.op
