SebastianHampl18/Bachelorarbeit/Option1/Option1.kicad_pcb

## KiCad design Option1/Option1.kicad_pcb (2025-10-30)

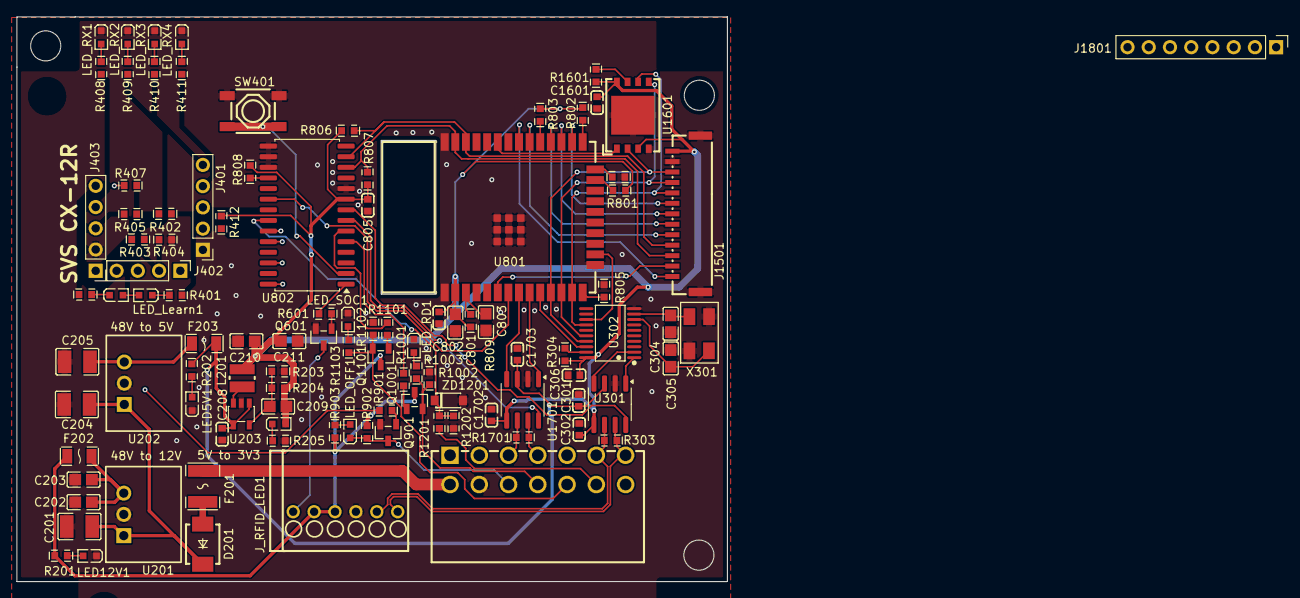
[picture p156: board Option1.kicad_pcb from above]

Board: 2 copper layers, 85.0 x 67.5 mm, 104 parts (0 on the bottom side), 83 nets.

Parts:
C201, C204: 10uF / 63V; C1210
C202, C203: 10uF / 16V; C0805
C205: 22uF / 10V; C1210
C208: 22uF / 6.3V; C0603
C209, C304, C305: 22pF; C0805
C210, C211, C801: 22uF; C0805
C301, C302, C306, C802, C805, C1601, C1702, C1703: 100nF; C0603
C803: 10 uF; C0805
D201: SS310_C14281; SMB_L4.6-W3.6-LS5.3-R-RD
F201: JK-MSMD030-60V; F1812
F202: JK-NSMD075-13.2; F1206
F203: JK-NSMD075; F1206
J401, J403: Conn_01x05_Pin; PinHeader_1x05_P2.54mm_Vertical
J402: Conn_01x04_Pin; PinHeader_1x04_P2.54mm_Vertical
J503: KF2EDGKRG-3.5-2*7P; CONN-TH_14P-P3.50_KEFA_KF2EDGKRG-3.5-2X7P
J999: Phoenix_Connetor_07x2pin_toWire; Phonix_Connector_07x2pin_toWire
J1501: GH-13AB; CONN-SMD_GH-13AB
J1801: Conn_01x08_Socket; PinHeader_1x08_P2.54mm_Vertical
J_RFID_LED1: 1989780; CONN-TH_6P-P2.50_1989780
L201: 2.2uH; IND-SMD_L3.0-W3.0_NR3010
LED3V3: XL-1608SYGC-06; LED0603-RD_GREEN
LED5V1: XL-1608SYGC-5; LED0603-RD_GREEN
LED12V1: XL-1608SYGC-12; LED0603-RD_GREEN
LED_Error1: XL-1608SYGC-06; LED0603-RD_GREEN
LED_Learn1: XL-1608SYGC-06; LED0603-RD_GREEN
LED_OFF1: XL-1608SYGC-06; LED0603-RD_GREEN
LED_RD1: XL-1608SYGC-06; LED0603-RD_GREEN
LED_RX1, LED_RX2, LED_RX3, LED_RX4: XL-1608SYGC-06; LED0603-RD_GREEN
LED_SOC1: XL-1608SYGC-06; LED0603-RD_GREEN
Q601, Q901, Q1001, Q1101: JY2302; SOT-23-3_L2.9-W1.3-P0.95-LS2.4-BR
R201, R903, R1003, R1103: 1.8kΩ; R0603
R202: 560Ω; R0603
R203: 150k; R0603
R204: 680k; R0603
R205, R401, R406, R408, R409, R410, R411: 220Ω; R0603
R303, R1701: 120Ω; R0603
R304, R801, R802, R803, R804, R805, R808: 10kΩ; R0603
R402, R407: 10K; R0603
R403, R404, R405, R412, R809, R902, R1002, R1102, R1202, R1601: 10k; R0603
R601, R901, R1001, R1101: 1k; R0603
R806, R807: 4.7kΩ; R0603
R1201: 27k; R0603
SW401: 4*4*1.7; SW-SMD_4P-L5.2-W5.2-P3.70-LS6.5
U201: U7812-500; PWRM-TH_3P-L11.6-W9.0-P2.54
U202: U7805-500; PWRM-TH_3P-L11.6-W9.0-P2.54
U203: SY8089AAAC; SOT-23-5_L3.0-W1.7-P0.95-LS2.8-BR
U301, U1701: TJA1051T-3; SOIC-8_3.9x4.9mm_P1.27mm
U302: MCP2515-I/ST; TSSOP-20_L6.5-W4.4-P0.65-LS6.4-BL
U801: ESP32-WROOM-32E-N4; WIFI-SMD_ESP32-WROOM-32E-A
U802: MCP23017_SO; SOIC-28W_7.5x17.9mm_P1.27mm
U1601: W25Q512JVEIQ; WSON-8_L8.0-W6.0-P1.27-TL-EP
X301: XL1EL89CSI-111YLC-8M; CRYSTAL-SMD_4P-L5.0-W3.2-BL-7I12288F20UCG
ZD1201: BZT52C3V6_C2113; SOD-123_L2.8-W1.8-LS3.7-RD

Connections:
3.3V: C209.1, C210.1, C211.1, C302.1, C306.1, C801.1, C802.1, C805.1, C1601.2, C1702.1, J403.1, J1501.13, J1801.8, L201.2, LED3V3.2 (A), LED_Error1.2 (A), LED_Learn1.2 (A), R204.1, R304.2, R402.2, R403.2, R405.2, R407.2, R412.1, R801.1, R802.1, R803.1, R806.2, R807.2, R808.2, R809.1, R1601.2, U301.5 (VIO), U302.20 (VDD), U801.2 (3V3), U802.9 (VDD), U1601.3 (WP#(IO2), U1601.8 (VCC), U1701.5 (VIO)
5V: C208.1, C301.1, C1703.1, F203.2, R202.2, U203.1 (EN), U203.4 (IN), U301.3 (VCC), U1701.3 (VCC)
12V: F202.2, J_RFID_LED1.2, J_RFID_LED1.3, Q1001.3 (D), Q1101.3 (D), R201.2, R902.2, R903.2
48V: F201.1, J503.2
48V_Fused: C201.1, C204.1, D201.2 (K), U201.1 (Vin), U202.1 (Vin)
/CAN1 Tranciever/CAN_H: J503.7, R1701.2, U1701.7 (CANH)
/CAN1 Tranciever/CAN_L: J503.5, R1701.1, U1701.6 (CANL)
/CAN1 Tranciever/CAN_S-Mode: U802.7 (GPB6), U1701.8 (S)
/CAN2_Tranciever/CAN_H: J503.13, J_RFID_LED1.6, R303.2, U301.7 (CANH)
/CAN2_Tranciever/CAN_L: J503.11, J_RFID_LED1.5, R303.1, U301.6 (CANL)
/CAN2_Tranciever/CAN_RX: U301.4 (RXD), U302.2 (RXCAN)
/CAN2_Tranciever/CAN_S-Mode: U301.8 (S), U802.8 (GPB7)
/CAN2_Tranciever/CAN_TX: U301.1 (TXD), U302.1 (TXCAN)
/MCT Wlan/ESP_EN: C803.2, R809.2, U801.3 (EN)
/MCT Wlan/LED_On: R601.2, U802.1 (GPB0)
/MCT Wlan/LED_Signal: R1201.1, R1202.2, U802.22 (GPA1), ZD1201.1 (K)
/MCT Wlan/SPI_CS_RFID: J1801.1, U802.3 (GPB2)
/MCT Wlan/SPI_RST_RFID: J1801.7, U802.4 (GPB3)
/MCT Wlan/TX_2 (Remote Drive): R1001.2, U802.5 (GPB4)
/MCT Wlan/TX_3 (SOC): R1101.2, U802.6 (GPB5)
/Notaus Schalter/Notaus_VCU: J503.6, LED_OFF1.1 (K), Q901.3 (D), R902.1
/Powersupply/12V_OUT: C202.1, C203.1, F202.1, U201.3 (Vout)
/RemoteDrive Schalter/RemoteDrive_VCU: J503.8, Q1001.2 (S), R1002.2, R1003.2
/SOC Schalter/SOC_VCU: J503.10, Q1101.2 (S), R1102.2, R1103.2
/Stecker Input/VCU_LED: J503.12, R1201.2
/Stecker LED - RFID/Status_LED -: J_RFID_LED1.1, Q601.3 (D)
F2_Sel: J402.2, R403.1, R404.1
Fehler_LED: J403.5, R406.1, R407.1, U802.23 (GPA2)
GND: C201.2, C202.2, C203.2, C204.2, C205.2, C208.2, C210.2, C211.2, C301.2, C302.2, C304.1, C305.1, C306.2, C801.2, C802.2, C803.1, C805.2, C1601.1, C1702.2, C1703.2, J401.1, J403.2, J503.4, J1501.12, J1501.14, J1501.15, J1801.6, J_RFID_LED1.4, LED5V1.1 (K), LED12V1.1 (K), LED_RD1.1 (K), LED_RX1.1 (K), LED_RX2.1 (K), LED_RX3.1 (K), LED_RX4.1 (K), LED_SOC1.1 (K), Q601.2 (S), Q901.2 (S), R203.2, R205.2, R404.2, R804.2, R805.2, R1002.1, R1102.1, R1202.1, SW401.3, SW401.4, U201.2 (GND), U202.2 (GND), U203.2 (GND), U301.2 (GND), U302.10 (VSS), U801.1 (GND), U801.15 (GND), U801.38 (GND), U801.39 (GND), U802.10 (VSS), U802.15 (A0), U802.16 (A1), U802.17 (A2), U1601.4 (GND), U1601.9 (EP), U1701.2 (GND), X301.2 (GND), X301.4 (GND), ZD1201.2 (A)
IO0: R802.2, U801.25 (IO0)
IO2: R804.1, U801.24 (IO2)
IO4: J1501.8, U801.26 (IO4)
IO5: R803.2, U801.29 (IO5)
IO13: U302.13 (~INT), U801.16 (IO13)
IO14: J1501.9, J1801.2, U302.14 (SCK), U801.13 (IO14), U1601.6 (CLK)
IO16: J1501.7, U801.27 (IO16)
IO17: J1501.6, U801.28 (IO17)
IO18: J1501.5, U801.30 (IO18)
IO19: J1501.1, U801.31 (IO19)
IO21: U801.33 (IO21), U1601.1 (~CS)
IO22: J1501.4, R806.1, U801.36 (IO22), U802.13 (SDA)
IO23: J1501.3, R807.1, U801.37 (IO23), U802.12 (SCK)
IO25: U302.18 (~CS), U801.10 (IO25)
IO26: J1501.11, J1801.4, U302.17 (SO), U801.11 (IO26), U1601.2 (DO(IO1))
IO27: J1501.10, J1801.3, U302.16 (SI), U801.12 (IO27), U1601.5 (DI(IO0))
IO32: U801.8 (IO32), U1701.4 (RXD)
IO33: U801.9 (IO33), U1701.1 (TXD)
IO34: J1501.2, U801.6 (IO34)
IO35: U801.7 (IO35), U802.20 (INTA)
LED_Modus: J401.3, R401.1, R402.1, U802.21 (GPA0)
Lernmodus: J401.2, R412.2, SW401.1, SW401.2, U802.2 (GPB1)
MTD0: R801.2, U801.23 (IO15)
MTD1: R805.1, U801.14 (IO12)
unnamed: D201.1 (A), F201.2
unnamed: LED3V3.1 (K), R205.1
unnamed: LED5V1.2 (A), R202.1
unnamed: LED12V1.2 (A), R201.1
unnamed: LED_Error1.1 (K), R406.2
unnamed: LED_Learn1.1 (K), R401.2
unnamed: LED_OFF1.2 (A), R903.1
unnamed: LED_RD1.2 (A), R1003.1
unnamed: LED_RX1.2 (A), R408.2
unnamed: LED_RX2.2 (A), R409.2
unnamed: LED_RX3.2 (A), R410.2
unnamed: LED_RX4.2 (A), R411.2
unnamed: LED_SOC1.2 (A), R1103.1
unnamed: Q601.1 (G), R601.1
unnamed: Q901.1 (G), R901.1
unnamed: Q1001.1 (G), R1001.1
unnamed: Q1101.1 (G), R1101.1
unnamed: C205.1, F203.1, U202.3 (Vout)
unnamed: C209.2, R203.1, R204.2, U203.5 (FB)
unnamed: L201.1, U203.3 (LX)
unnamed: C304.2, U302.9 (OSC1), X301.3
unnamed: C305.2, U302.8 (OSC2), X301.1
unnamed: R304.1, U302.19 (~RESET)
unnamed: R808.1, U802.18 (~RESET)
unnamed: R1601.1, U1601.7 (~HOLD/RESET#(IO3))
RX_1: J402.4, R408.1, R901.2
RX_2: J402.3, R409.1, U802.24 (GPA3)
RX_3: J401.5, R410.1, U802.26 (GPA5)
RX_4: J401.4, R411.1, U802.28 (GPA7)
TX_Analog: J403.3, R405.1
