SebastianHampl18/Bachelorarbeit/(commit log)

2025-05-28 Stand mit annähernd fertigem Schaltplan, Flashen, SPIFlash, Display, MCT Beschaltung fehlen;Datenbläter, etc
    [BOM-Option1.csv, CAN.kicad_sch, Input.kicad_sch, Micro_USB.kicad_sch, Notaus.kicad_sch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]
2025-05-30 SPI Flash hinzugefügt, IN/Outputs vereinheitlicht, USB Flash Möglichkeit hinzugefügt, Display fehtl noch
    [CAN.kicad_sch, Input.kicad_sch, Micro_USB.kicad_sch, Notaus.kicad_sch, Option1.kicad_sch, RemoteDrive.kicad_sch, SOC Schalter.kicad_sch, SPI_Flash_Storage.kicad_sch]
2025-06-03 Added Export for Review 1
    [Micro_USB.kicad_sch, Option1.kicad_sch, VCU_LED_Auswertung.kicad_sch]
2025-06-13 USB auf 3V3 umgebaut
    [Micro_USB.kicad_sch, Notaus.kicad_sch, Option1.kicad_pcb, Option1.kicad_sch, RFID.kicad_sch, RemoteDrive.kicad_sch, SOC Schalter.kicad_sch, SPI_Flash_Storage.kicad_sch]
2025-06-19 Erste issues eingearbeitet
    [CAN.kicad_sch, CAN1.kicad_sch, Input.kicad_sch, Option1.kicad_sch, microcontroller.kicad_sch, power_supply.kicad_sch, radio_reciever.kicad_sch]
2025-06-19 Datenblätter für korrigierten SPI-Flash und CAN2 Controller Oszillator hinzugefügt
2025-06-19 Oszillator für CAN-Controller hinzugefügt, Abschlusswiderstände eingefügt
    [CAN.kicad_sch]
2025-06-19 Transitor getauscht, Pulldown Widerstände für Definierten LOW Pegel hinzugefügt
    [Notaus.kicad_sch, RemoteDrive.kicad_sch, SOC Schalter.kicad_sch, Treiber_LED.kicad_sch]
2025-06-19 Widerstandswerte des Spannungsteiler angepasst und korrigiert
    [VCU_LED_Auswertung.kicad_sch]
2025-06-19 Zweite 3V3 Spannungsversorgung für Display hinzugefügt
    [power_supply.kicad_sch]
2025-06-19 SPI Flash getauscht
    [SPI_Flash_Storage.kicad_sch]
2025-06-19 Pojekt und Backups
    [Option1.kicad_sch]
2025-06-19 Alte Stecker zum litzen verschrauben auf Platine vorgesehn, 14 Pin Stecker zum Stecken fehlt, RFID und LED abklären
    [Input.kicad_sch, Option1.kicad_sch]
2025-06-23 USB Schaltung angepasst, Transistoren korrigiert, Stecker ausgetauscht, Dioden hinzugefügt
    [CAN.kicad_sch, Input.kicad_sch, Micro_USB.kicad_sch, Option1.kicad_pcb, Option1.kicad_sch, microcontroller.kicad_sch, power_supply.kicad_sch, radio_reciever.kicad_sch]
2025-06-23 Layout für Powersupply, CAN und Stecker hinzugefügt
    [CAN1.kicad_sch, Input.kicad_sch, Option1.kicad_pcb, power_supply.kicad_sch]
2025-06-25 MCT und SPI zu Layout hinzugefügt
    [Input.kicad_sch, Notaus.kicad_sch, Option1.kicad_pcb, Stecker Display.kicad_sch, microcontroller.kicad_sch]
2025-06-26 funkempfänger mit Beschaltung zu Layout hinzugefügt, SPI und I2C teilnehmer geroutet, Löcher hinzugefügt, Stecker platziert
    [Input.kicad_sch, Option1.kicad_pcb]
2025-07-01 Layout komplett bis auf RFID Leiste und 3V3 Erzeugung Display
    [Input.kicad_sch, Micro_USB.kicad_sch, Option1.kicad_pcb, Option1.kicad_sch, stecker_LED.kicad_sch]
2025-07-01 3V3 für Display hinzugefügt und gelayoutet, Brücke zwischen Display und Std 3V3 hinzugefügt in Schaltplan und Platine
    [Option1.kicad_pcb, power_supply.kicad_sch]
2025-07-15 GND polygon hinzugefügt, unverbundene Pads verknüpft, 0 Ohm Widerstand für Display Strohmversorgung hinzugefügt
    [CAN.kicad_sch, CAN1.kicad_sch, Option1.kicad_pcb, power_supply.kicad_sch]
2025-07-17 EasyEDA Lib in Projekt verschoben; Footprints, Silkscreen für designrule angepasst; Bauteilbeschriftungen entfernt, müssen neu angeordnet werden, JLC Rules eingebunden, Designrules erfolgreich bis au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
    [Micro_USB.kicad_sch, Option1.kicad_pcb, Option1.kicad_sch, microcontroller.kicad_sch, radio_reciever.kicad_sch]
2025-07-22 Leiterbahndicke hinzugefügt, Via-Dicke angepasst, Bauteil referenzen hinzugefügt
    [Option1.kicad_pcb]
2025-07-22 Stand 1 PCB Review
2025-07-28 Stecker nach hinten verschoben, Platine am vorderen Rand verlängert, Farbprints + Ref Feld hinzugefügt, Review eingearbeitet: Leiterbahnen dicker gemacht für Spannungsversorgung, Löcher verschoben, K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
    [Option1.kicad_pcb]
2025-07-29 Dokument für Bachelorarbeit hinzugefügt und ersten Entwurf für Inhaltsverzeichnis erstellt
2025-07-29 Minimale Änderungen, Ausschnitt für USB Größer
    [Option1.kicad_pcb]
2025-07-31 C++ Projekt begonnen mit PlatformIO in VS Code; headerdatei mit defines angelegt, init_ports funktion, funktionen als Prototypen angelegt
2025-07-31 LEDs für RX Ausgänge des Funkmodules hinzugefügt
    [Option1.kicad_pcb, radio_reciever.kicad_sch]
2025-08-02 interrupts angelegt
2025-08-04 Vorlage für Paarvergleich und Nutzwertanalyse erstellt
    [Paarvergleich_Nutzwertanalysen.xlsx]
2025-08-06 Kapitel 4 - Konzepte begonnen mit Erklärung zu Paarvergleichen und Nutzwertanalysen
2025-08-06 Paarvergleich für Wifi begonnen, Kopitel 4.1 paarvergleiche algemeines vorgehen und system beschrieben
    [Paarvergleich_Nutzwertanalysen.xlsx]
2025-08-08 Funktionen für Read/Write I2C hinzugefügt, test steht aus
2025-08-09 GPIO Expander Functionen für Write und read vollendet, begonnen Funktionen durch Read/Write I2C zu erweitern, wo sie benötigt werden
2025-08-14 Kabelseitigen Stecker für JLC Bestellung hinzugefügt. Footprint erstellt und 3D Modell hinzugefügt, Footprint/3DModell von 6Pin Stecker und Fuse korrigiert
    [Option1.kicad_pcb]
2025-08-14 Added interrupt inits and interrupt service routines for GPIO Expansion
2025-08-15 Platine verkleinert, um besser in gehäuse zu passen, PullUp Widerstand an Button hinzugefügt
    [Option1.kicad_pcb, radio_reciever.kicad_sch]
2025-08-15 Interrupt Service Routinen und Abarbeitung der ISR Flags in Main hinzugefügt. Nur Interrupts vom GPIO Expander, Keine Interrupt behandlung für CAN oder SPI
2025-08-17 LEDs an Transistoren hinzugefügt, Layout angepasst, LEDs eingefügt, LEDs zeigen an, ob Transsitor durchgeschalten ist
    [Notaus.kicad_sch, Option1.kicad_pcb, RemoteDrive.kicad_sch, SOC Schalter.kicad_sch]
2025-08-17 Learn RF Controll Function erstelllt und begonnen
2025-08-18 Added handling for RF_Learning including RF ACK and Error handling
    [main.cpp, option1.cpp]
2025-08-18 learn rf angepasst, es werden keine schleifen mehr durchlaufen, es gibt kein delay, stattdessen über millis() gelöst
2025-08-19 Neue STEP Modelle erzeugt und exportiert
    [Option1.step]
2025-08-19 Gerber Files, Production Files und weitere Fabrication Dateien für JLC PCB Bestellung erstellt
    [BOM-Option1.csv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]
2025-08-19 Library korrigiert auf Projekt Library. Footprints in Fabrication Files korrigiert. Neue Gerber files, BOM und Positionsdaten erstellt, Bestellung 1 Zip Datei entfernt
    [Option1-CuBottom.gbr, Option1-CuTop.gbr, Option1-EdgeCuts.gbr, Option1-MaskBottom.gbr, Option1-MaskTop.gbr, Option1-NPTH.drl, Option1-PTH.drl, Option1-SilkBottom.gbr]
2025-08-19 BOM und Positionsdaten korrigiert
    [BOM-Option1.csv, Micro_USB.kicad_sch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]
2025-08-19 Gerber und Fabrication Files feretig für bestellung, muss mit andreas reden. Alle Pinheader von Platine und Stüclkliste ausgeschlossen
2025-08-19 Reset SPI ohne delay() umgebaut; Datenblatt von RFID Reader hinzugefügt
    [main.cpp, option1.cpp]
2025-08-21 Programming Header hinzugefügt für flashen via DevKit
    [Micro_USB.kicad_sch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]
2025-08-27 init_ca und process Can für CAN1 hinzugefügt
2025-08-28 INIT WIFI und webseiten hinzugefügt
2025-08-30 Funktionen für send und receive CAn Messages hinzugefügt, auswertung der CAN Messages fehlt;
    Send SOC und Remote Drive in main verschoben für zugriff auf CAn Objekt;
    Livedatenseite mti Java Skript hinzugefügt zur aktualisierung der Daten;
    Design für Livedaten, Root undEinstellungen festgelegt;
    ESP Storage initial values auf true gesetzt;
    Abfrage der im NVS gespeicherten Daten zur freischaltung der einzelnen funktionen durch erlauben des pollings im loop;
2025-09-01 CAN1 decode und funktionen zur verarbeitung einzelner signale hinzugefügt, Structs für CAN-Signal und CAN-Messages erstellt und DBC Files nachgebildet
2025-09-02 LED Blinken via CAN hinzugefügt, sowohl dauerhaft als auch mit definierter anzahl; Realisiert über Softwaretimer
2025-09-02 can2 init und isr für Can2 mit process can 2 hinzugefügt. SPI Register read und write hinzugefügt
2025-09-03 Beschreibund des aktuellen Systems und der Anforderungen begonnen
2025-09-04 Hertseller Einstellungen Webseite aufgebaut. Funktion zum Debugging der NvS hinzugefügt
2025-09-05 SOC Signal angelegt und zur Message PowerData hinzugefügt.
    Signal in Main definiert und hinzugefügt; CAN Schreibt direkt in global Variable für Webserver; Webserver für Herstellersettings angepasst, vollständig getestet und als SlideButton realisiert; Webserver voll funktionsfähig und fertig; ISR für CAN2 und GPIO Expansion umgebaut ohne I²C und SPI abfragen in ISR
2025-09-08 Solved some todos; CAN 2 init error handling; Added Librarys for Display
    [main.cpp, option1.cpp]
2025-09-08 Anforderungen und Integration ions bestehende System übernommen
2025-09-09 Datenblätter für TouchController hinzugefügt, Library für Display eingebunden und hinzugefügt; InitDisplay begonnen - NACK Fehler bei I²C Communication
2025-09-15 Erklärunge nchaltplan MCT und GPIO Exp fertig
2025-09-16 Schaltplan zu bachelorarbeit Dokument hinzuigefügt. Fertigf bis SPI Flash
    [CAN.kicad_sch, CAN1.kicad_sch, radio_reciever.kicad_sch]
2025-09-17 Kapitel über Schaltplan fortgesetzt, Fehler in Schaltplan korrigiert, DCDC getauscht, USB Schaltung angepasst, 3.3V Schaltung angepasst
    [Micro_USB.kicad_sch, SPI_Flash_Storage.kicad_sch, power_supply.kicad_sch]
2025-09-18 Platine korrigeiert, 5V DCDC getauscht, 3.3V Display Versorgung entfernt. Bauteile neu angeordnet, USB 5V auf 5V Supply geführt
    [Input.kicad_sch, Micro_USB.kicad_sch, Option1.kicad_pcb, Option1.kicad_sch, Stecker Display.kicad_sch, power_supply.kicad_sch, stecker_LED.kicad_sch]
2025-09-18 Notizen für PCB Design
2025-09-21 Kapitel 6 begonnen, Codeteile angepasst, GPIO Exp WriteBit korrigiert, Send SOC /RemoteDrive Delay entfernt
    [Option1.kicad_pcb]
2025-09-23 Kapitel 6 abgeschlossen, beschreibung von Nutzwertanalysen hinzugefügt, Paarvergleich für Wlan hinzugefügt, Konzeptbetrachtung für WiFi vorhanden, nicht in Doku eingearbeitet
    [Paarvergleich_Nutzwertanalysen.xlsx]
2025-09-24 Kapitel 4 abgeschlossen
    [Paarvergleich_Nutzwertanalysen.xlsx]
2025-09-26 Kapitel 2 abgeschlossen, Kapitel 1 und 8 fertig, Literatur fehlt für Kapitel 4, 5, 6, Kapitel 7 fehlt
2025-09-28 Beschreibung der Funktion send_remoteRequest entfernt
2025-09-28 Ko0mmentare im Loop für LED-Signal verkürzt
2025-09-29 Dokument zum Drucken und zur Abgabe per Email fertig und abgegeben
2025-10-20 Layout komplett neu überarbeitet, Neu Pinbelegung MCT, USB beschaltung muss noch korrigert werden
    [Option1.kicad_pcb, microcontroller.kicad_sch]
2025-10-22 Kleine Änderungen
    [Option1.kicad_pcb]
2025-10-27 power Supply angepasst für 12V und 48V, Datenblätter für DCDCs hinzugefügt
    [Input.kicad_sch, Option1.kicad_pcb, Option1.kicad_sch, microcontroller.kicad_sch, power_supply.kicad_sch, stecker_LED.kicad_sch]
2025-10-27 USB Beschaltung teilweise korrigiert, Fehlerbehebung steht aus
    [Micro_USB.kicad_sch]
2025-10-29 Abschlusspräsentation hinzugefügt, Platinenform angepasst
    [Option1.kicad_pcb]
2025-10-30 Fertigfe Abschlusspräsentation
    [Micro_USB.kicad_sch, Option1.kicad_pcb, VCU_LED_Auswertung.kicad_sch]
